benediktibk/battery-system/hardware/battery-management-system/design_errors_r03.txt

open:
footprint for EEPROM wrong
use INAs for cell measurement for increased precision

done:
