benediktibk/battery-system/calculations/battery_system.ods

Sheet: specifications
maximum current [A] | 30
minimum cell voltage [V] | 2.5
maximum cell voltage [V] | 3.6
cell series count | 4
minimum battery voltage [V] | 10
maximum battery voltage [V] | 14.4
cell capacity [Ah] | 88
nominal cell voltage [V] | 3.2
nominal battery voltage [V] | 12.8
cell energy [Wh] | 1126.4
maximum input voltage [V] | 30
internal resistance [Ohm] | 0.2

Sheet: charge and discharge FETs
pull up [kOhm] | 220
pull up current [mA] | 0.0581818181818182
drain source resistance [mOhm] | 7
power loss per FET [mW] | 210
power loss per pull up [mW] | 0.745
complete discharge time per pull up [h] | 1512500
complete discharge time per pull up [a] | 173
input capacitance [pF] | 4140
input capacitance tau [s] | 0.0009108
loading time input capacitance [us] | 2094.84

Sheet: balancing
cell voltage difference [V] | 0.1
cell capacitance [F] | 99000
energy difference [Ws] | 15840
balance time [s] | 3600
average balance power [W] | 4.4
charging factor | 1.59
peak power [W] | 13.97
peak current necessary [A] | 4.37
RDS on [Ohm] | 0.05
damping resistor [Ohm] | 0.002
total charge resistance [Ohm] | 0.302
Initial peak current [A] | 10.596
continuous peak current [A] | 0.331
initial power loss damping resistor [W] | 0.225
continuous power loss damping resistor [W] | 0.000
continuous power loss charge [W] | 0.0331125827814571
capacity [F] | 0.01
charging tau [s] | 0.00302
time till 90% full [s] | 0.006954
time till 90% full [us] | 6954
MOSFET turn on and turn of time [ns] | 61
MOSFET turn on and turn of time [s] | 0.000000061
charge and balance time [s] | 0.013907735961684
charge and balance time [ms] | 13.908
energy transferred per charge [Ws] | 0.0000404
energy transferred per cycle [Ws] | 0.0000202
time till balanced [s] | 784158415.841584
time till balanced [h] | 217821.782178218
time till balanced [a] | 24.8484807412979

Sheet: balancing_relais
cell voltage difference [V] | 0.1
cell capacitance [F] | 99000
energy difference [Ws] | 15840
reed resistance [Ohm] | 0.15
reed maximum current [A] | 1
initial current [A] | 0.35
charging capacitor [F] | 360.00
series resistance capacitor [Ohm] | 0.135
charging tau [s] | 102.60
time till 90% full [s] | 236.25
energy transfer per cycle [Ws] | 1.46
time till balanced [s] | 10864.1975308642
time till balanced [h] | 3.01783264746228
cycles till balanced | 45.987
energy stored in balancing capacitor [Ws] | 2332.800
energy stored in battery pack [Ws] | 4055040.000
energy stored in balancing capacitor [%] | 0.058

Sheet: supercap_selection
RS order number | capacitance [F] | Price [€] | price per capacitance [€/F]
875-6723 | 15 | 3.709 | 0.247
875-6720 | 90 | 8.755 | 0.097

Sheet: balancing_inductor
cell voltage difference [V] | 0.1
cell capacitance [F] | 99000
energy difference [Ws] | 15840
inductance [H] | 0.0022 | Würth 7447709222
parasitic resistance [Ohm] | 3.25
maximum DC current [A] | 0.53
saturation current [A] | 0.75
resistance nmos [Ohm] | 0.2
number of inductors | 1
total resistance [Ohm] | 3.45
total inductance [H] | 0.0022
initial current [A] | 1.04347826086957
time constant [s] | 0.00063768115942029
cycle time on [s] | 0.00063768115942029
cycle time off [s] | 0.00127536231884058
total cycle time [s] | 0.00191304347826087
energy loss per cycle, approx [Ws] | 0.00718638941398866
energy transfer per cycle, approx [Ws] | 0.0269958280595052
power transfer, approx [W] | 3.75652173913044
time till balanced [s] | 4216.66666666667
time till balanced [h] | 1.1712962962963

Sheet: balancing_inductor_v2
cell voltage difference [V] | 0.1
cell capacitance [F] | 99000
energy difference [Ws] | 15840
inductance [µH] | 6.2 | Würth 7447706062
inductance [H] | 0.0000062
parasitic resistance [Ohm] | 0.015
maximum DC current [A] | 7
saturation current [A] | 10
resistance nmos [Ohm] | 0.028 | DMN3404L
additional resistance [Ohm] | 0.5
power loss on resistance, peak [W] | 21.9773511187082 | RS online 820-0069
total resistance [Ohm] | 0.543
total inductance [H] | 0.0000062
initial current [A] | 6.62983425414365
time constant [s] | 1.14180478821363E-05
cycle time on [s] | 1.14180478821363E-05
cycle time off [s] | 2.28360957642726E-05
total cycle time [s] | 3.42541436464088E-05
energy loss per cycle, approx [Ws] | 0.000817557461615946
energy transfer per cycle, approx [Ws] | 0.0195129736695077
power transfer, approx [W] | 23.8674033149171
time till balanced [s] | 663.666666666667
time till balanced [h] | 0.184351851851852
maximum PWM count frequency [MHz] | 32
minimum PWM count period [s] | 0.00000003125
turn on delay time [ns] | 3.41
turn on rise time [ns] | 6.18
turn off delay time [ns] | 13.92
turn off fall time [ns] | 2.84
switching time [s] | 0.00000002635
power loss nmos [W] | 1.23073166264766

Sheet: balancing_inductor_v3
cell voltage difference [V] | 0.1
cell capacitance [F] | 99000
energy difference [Ws] | 15840
inductance [µH] | 220 | 789-6971
inductance [H] | 0.00022
parasitic resistance [Ohm] | 0.439
maximum DC current [A] | 1
saturation current [A] | 1
resistance nmos [Ohm] | 0.028 | DMN3404L
additional resistance [Ohm] | 3.544
power loss on resistance, peak [W] | 2.85491636966181 | RS online 820-0069
total resistance [Ohm] | 4.011
total inductance [H] | 0.00022
initial current [A] | 0.897531787584144
time constant [s] | 5.48491647968088E-05
cycle time on [s] | 0.000054849
cycle time off [s] | 0.000109698329593618
total cycle time [s] | 0.000164547494390426
energy loss per cycle, approx [Ws] | 0.000531671784417832
energy transfer per cycle, approx [Ws] | 0.00171789237747572
power transfer, approx [W] | 3.23111443530292
time till balanced [s] | 4902.33333333333
time till balanced [h] | 1.36175925925926
maximum PWM count frequency [MHz] | 32
minimum PWM count period [s] | 0.00000003125
turn on delay time [ns] | 3.41
turn on rise time [ns] | 6.18
turn off delay time [ns] | 13.92
turn off fall time [ns] | 2.84
switching time [s] | 0.00000002635
power loss nmos [W] | 0.0225557726722717
