benediktibk/battery-system/casing/casing-complete_lid.stl

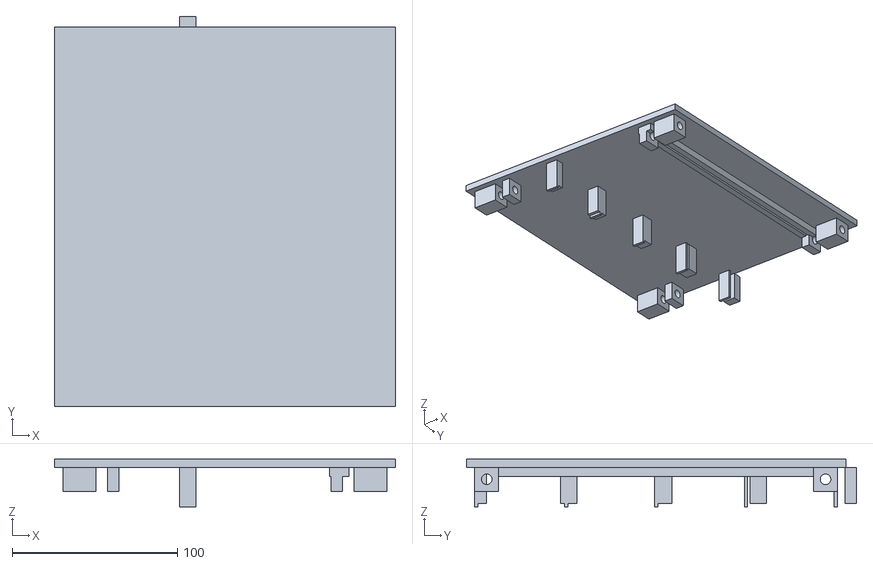
[picture p1: CAD file, 2024-04-21]
casing/casing-complete_lid.stl
206.4 x 236.1 x 29.0
