benediktibk/battery-system/casing/casing-complete_base.stl

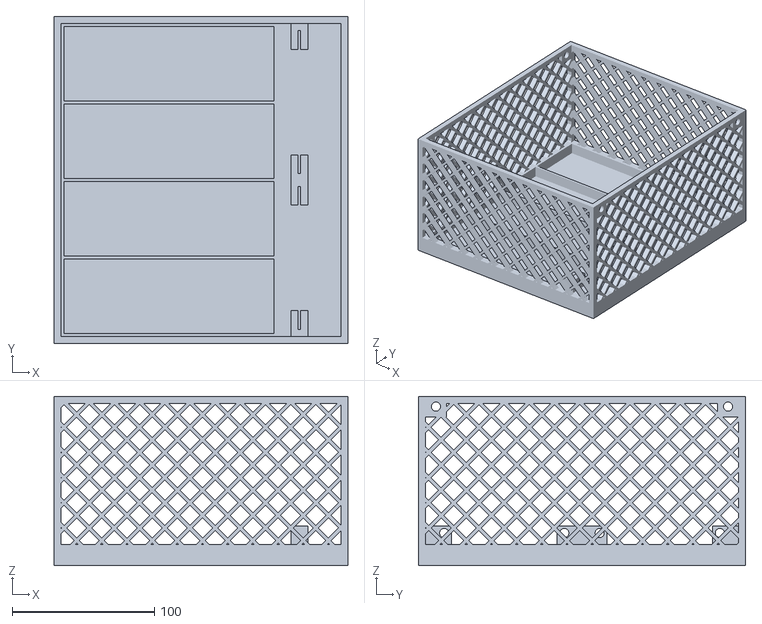
[picture p2: CAD file, 2024-04-21]
casing/casing-complete_base.stl
206.4 x 229.6 x 119.0
