benediktibk/battery-system/casing/casing-cells.stl

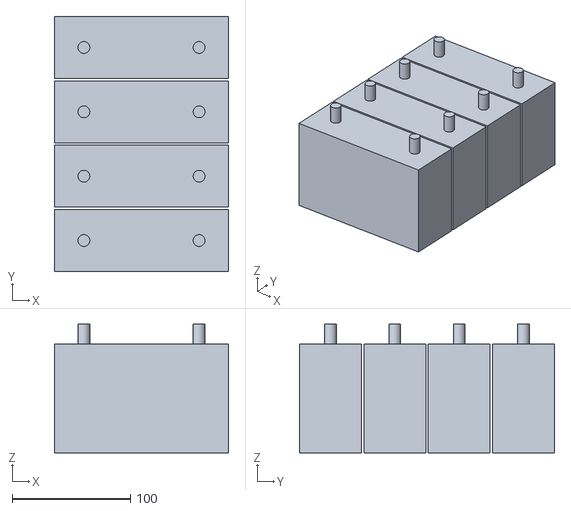
[picture p3: CAD file, 2024-04-21]
casing/casing-cells.stl
147.4 x 215.6 x 109.0
