benediktibk/battery-system/casing/casing.FCStd

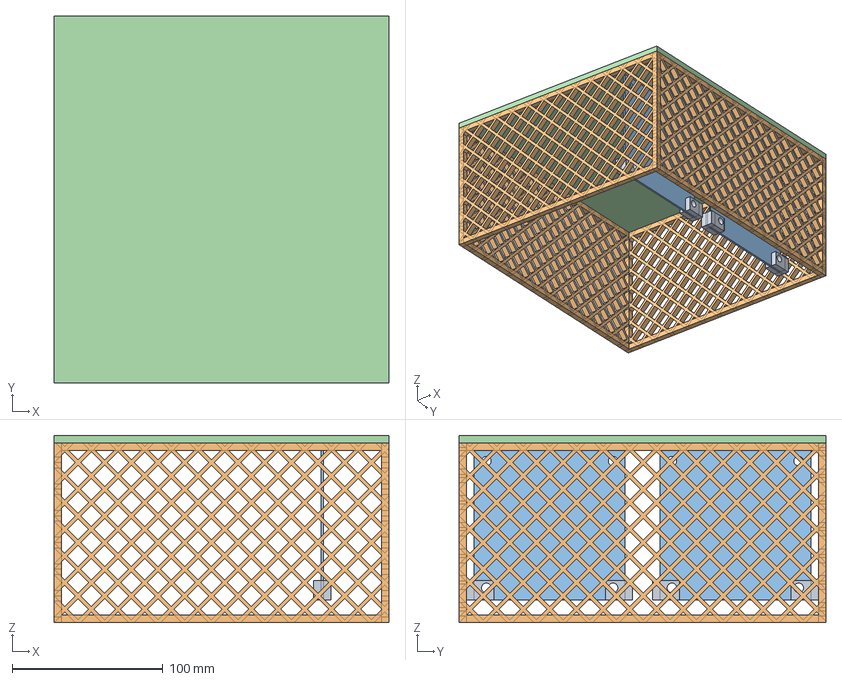
[picture p4: CAD file, 2024-04-16]
casing/casing.FCStd
222.0 x 243.0 x 124.0 mm
pcb_mounts
walls
pcbs
lid_plate
