benediktibk/battery-system/simulations/cell_measurement.asc

M1: pmos
M2: pmos
M3: pmos
M4: pmos
M5: nmos
R1: res; 1000000
R2: res; 100000
R3: res; 24000
R4: res; 100000
R5: res; 100000
R6: res; 24000
R7: res; 36000
R8: res; 68000
R9: res; 100000
R10: res; 1000
R11: res; 1000
R12: res; 1000
R13: res; 1000
U1: AD711
U2: AD711
U3: AD711
U4: AD711
V1: voltage; 20
V2: voltage; 3
V3: voltage; 3
V4: voltage; 3
V5: voltage; 3
V6: voltage; PULSE(0 3.3 0.1 0.001 0.001 1)
Named nets: 0
.tran 1
