benediktibk/battery-system/simulations/battery_cell_configuration_change.asc

C1: cap; 99000; Rser=100m,IC=2
C2: cap; 99000; Rser=100m,IC=2
M1: nmos; Si7336ADP
M2: nmos; Si7336ADP
M3: nmos; Si7336ADP
M4: nmos; Si7336ADP
M5: nmos; Si7336ADP
M6: nmos; Si7336ADP
R1: res; 2000
R2: res; 1000
R3: res; 2000
V1: voltage; PULSE(10 0 0.5 0 0 0.5 1)
V2: voltage; PULSE(0 10 0.1 0 0 0.1 0.2)
Named nets: 0
.tran 1
