benediktibk/battery-system/simulations/Draft3.asc

C1: cap; 0.000056; Rser=0.002
C2: cap; 0.000056; Rser=0.002
L1: ind; 0.0000025; Ipk=100 Rser=2.6m
M1: nmos; Si7336ADP
M2: nmos; Si7336ADP
M3: nmos
R2: res; 0.004
R3: res; 240
R4: res; 100000
V1: voltage; 12
V2: voltage; PULSE(0 30 0.1 0 0 0.855u 10u)
V3: voltage; 30
Named nets: 0
.tran 1
