benediktibk/battery-system/simulations/dc_dc_converter_filter.asc

C1: cap; 0.0000470
L1: ind; 0.0000025
R: res; 2.4
V1: voltage; PULSE(24 24.037 0 0.000001 0.000001 0.000001 0.000004)
Named nets: 0
.tran 0.1
