benediktibk/battery-system/simulations/Draft2.asc

M1: pmos
M2: nmos
R1: res; 220000
R2: res; 1000
V1: voltage; 18
V2: voltage; PULSE(0 3 1 0 0 1 1)
Named nets: 0
