benediktibk/battery-system/simulations/high_side_switch.asc

M1: pmos; AO6407
M2: nmos; BSB012N03LX3
R1: res; 220000
R2: res; 1000
V1: voltage; 18
V2: voltage; PULSE(0 3 1 0 0 1 2)
Named nets: 0
.tran 10
