benediktibk/battery-system/simulations/balance_inductance_v3.asc

C1: cap; 99000; Rser=0.2,IC=3.2
C2: cap; 99000; Rser=0.2,IC=3.2
C3: cap; 99000; Rser=0.2,IC=3.2
C5: cap; 99000; Rser=0.2,IC=3.3
L1: ind; 0.00022; Rser=0.439
L2: ind; 0.00022; Rser=0.439
L3: ind; 0.00022; Rser=0.439
L4: ind; 0.00022; Rser=0.439
M1: nmos; BSB012N03LX3
M2: nmos; BSB012N03LX3
M3: nmos; BSB012N03LX3
M4: nmos; BSB012N03LX3
M5: nmos; BSB012N03LX3
M6: nmos; BSB012N03LX3
M7: nmos; BSB012N03LX3
M8: nmos; BSB012N03LX3
M9: nmos; BSB012N03LX3
M10: nmos; BSB012N03LX3
M11: nmos; BSB012N03LX3
M12: nmos; BSB012N03LX3
R1: res; 100
R2: res; 100
R3: res; 100
R4: res; 100
V1: voltage; PULSE(0 18 0 0 0 0.0005 0.00055)
V2: voltage; 18
V3: voltage; PULSE(0 18 0.01 0 0 1 1.01)
Named nets: 0
.tran 100
