benediktibk/battery-system/simulations/Draft1.asc

C1: cap; 99000; Rser=0.2,IC=3.2
C2: cap; 99000; Rser=0.2,IC=3.3
C3: cap; 99000; Rser=0.2,IC=3.2
C4: cap; 99000; Rser=0.2,IC=3.2
D1: schottky; 1N5817
D2: schottky; 1N5817
L1: ind; 0.01; Ipk=0.11 Rser=39
M1: nmos; BSB012N03LX3
M2: nmos; BSB012N03LX3
M3: nmos; BSB012N03LX3
M4: nmos; BSB012N03LX3
M5: nmos; BSB012N03LX3
R1: res; 100000
V1: voltage; PULSE(0 18 0.1 0 0 0.0005 0.001)
V2: voltage; 18
Named nets: 0
.tran 100
