benediktibk/battery-system/simulations/balance_fets.asc

C1: cap; 99000; IC=3.2
C2: cap; 99000; IC=3.3
C3: cap; 0.010
C4: cap; 0.010
C5: cap; 0.001
C6: cap; 0.001
M1: nmos; PSMN0R925YLC
M2: nmos; PSMN0R925YLC
M3: nmos; PSMN0R925YLC
M4: nmos; PSMN0R925YLC
M5: nmos; PSMN0R925YLC
M6: nmos; PSMN0R925YLC
M7: nmos; PSMN0R925YLC
M8: nmos; PSMN0R925YLC
M9: nmos; PSMN0R925YLC
M10: nmos; PSMN0R925YLC
M11: nmos; PSMN0R925YLC
M12: nmos; PSMN0R925YLC
R1: res; 0.5
R2: res; 0.5
R3: res; 1000
R4: res; 1000
R5: res; 1000
R6: res; 1000
R7: res; 0.2
R8: res; 0.2
V1: voltage; PULSE(0 3.3 0.1 0 0 0.001 0.0025)
V2: voltage; PULSE(0 3.3 0.1015 0 0 0.0005 0.0025)
V3: voltage; 20
Named nets: 0, charge_pmos, charge_nmos, balance_pmos, balance_nmos, charge, balance
.tran 100
