benediktibk/battery-system/simulations/charge_and_discharge_fets.asc

D1: diode; customDiode
D2: diode; customDiode
M1: nmos
M2: nmos
Qcharge: pmos; AO6407
Qdischarge: pmos; AO6407
R1: res; 0.1
R2: res; 10
R3: res; 100000
R4: res; 100000
V1: voltage; 12
V2: voltage; 0
V3: voltage; 14
V4: voltage; 0
Named nets: 0
.op
.model customDiode D(Ron=1 Roff=1Meg Vfwd=0.5 Vrev=2)
