benediktibk/battery-system/hardware/battery-management-system/battery-management-system.kicad_pcb

## KiCad design hardware/battery-management-system/battery-management-system.kicad_pcb (2025-03-11)

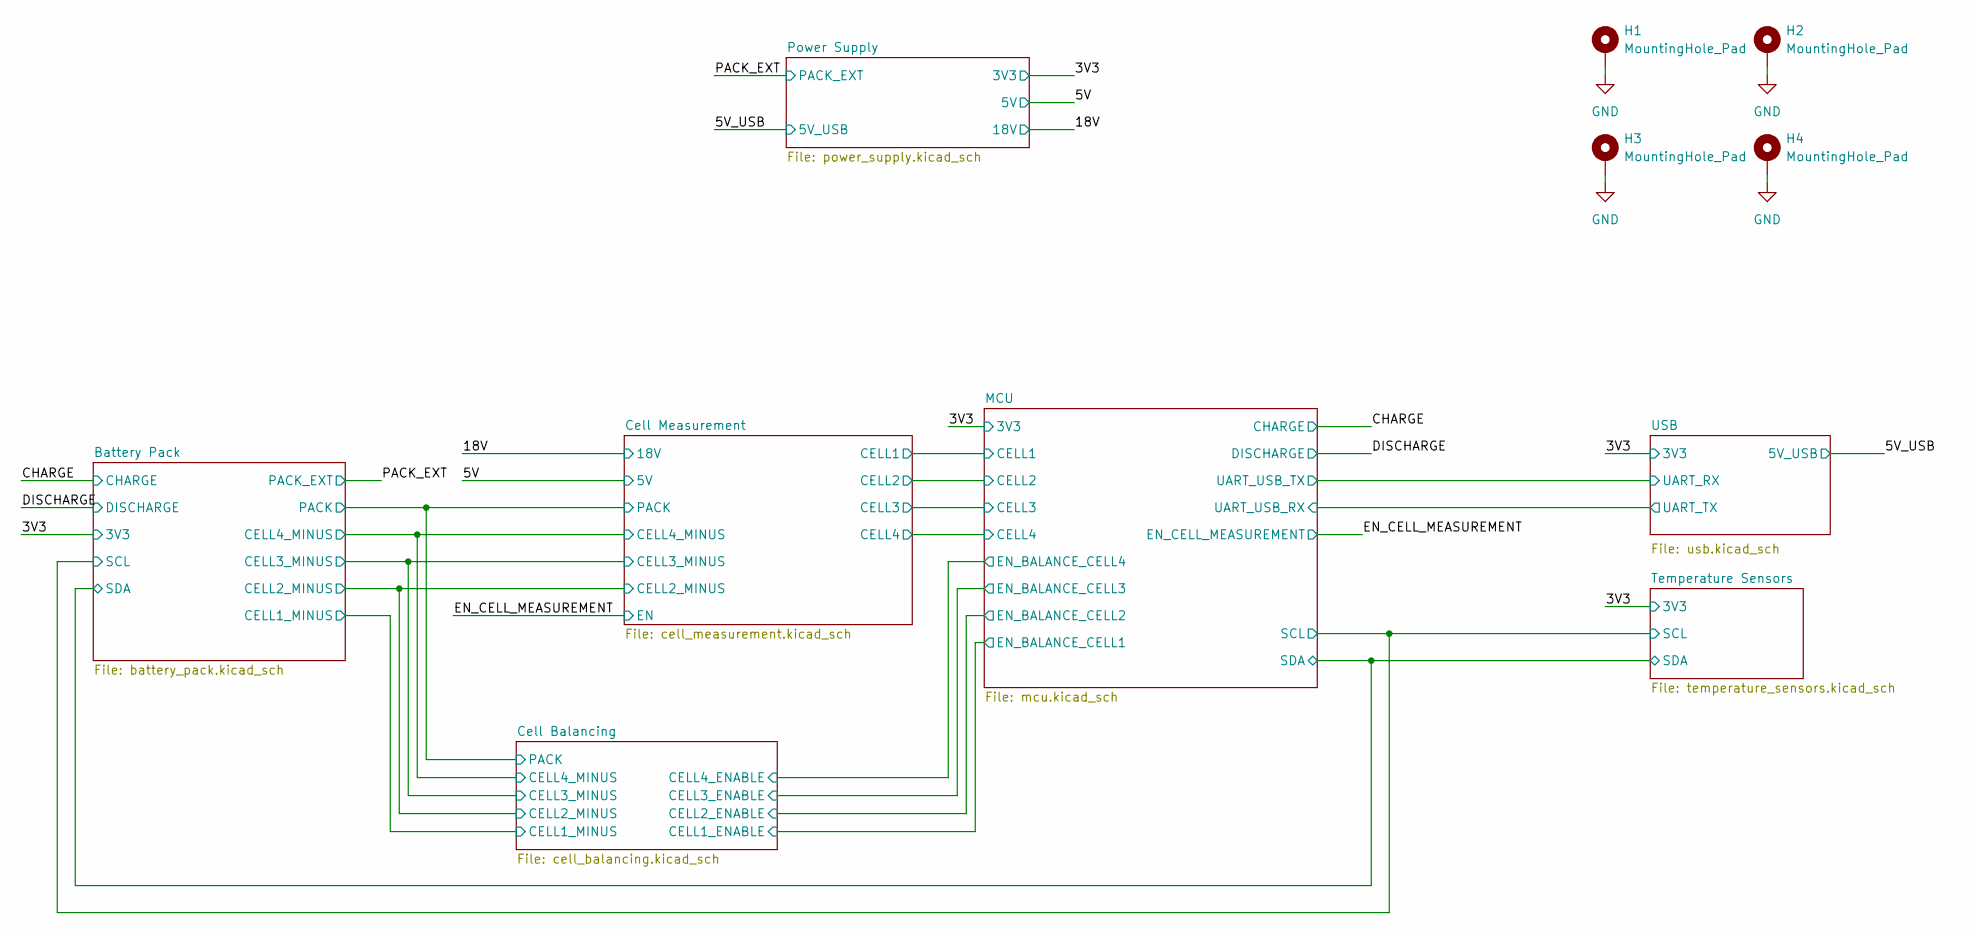
[picture p5: schematic battery-management-system.kicad_sch]

Parts:
H1, H2, H3, H4: MountingHole_Pad; MountingHole_6.4mm_M6_Pad_TopBottom

Connections:
GND: H1.1, H2.1, H3.1, H4.1; also elsewhere on the board

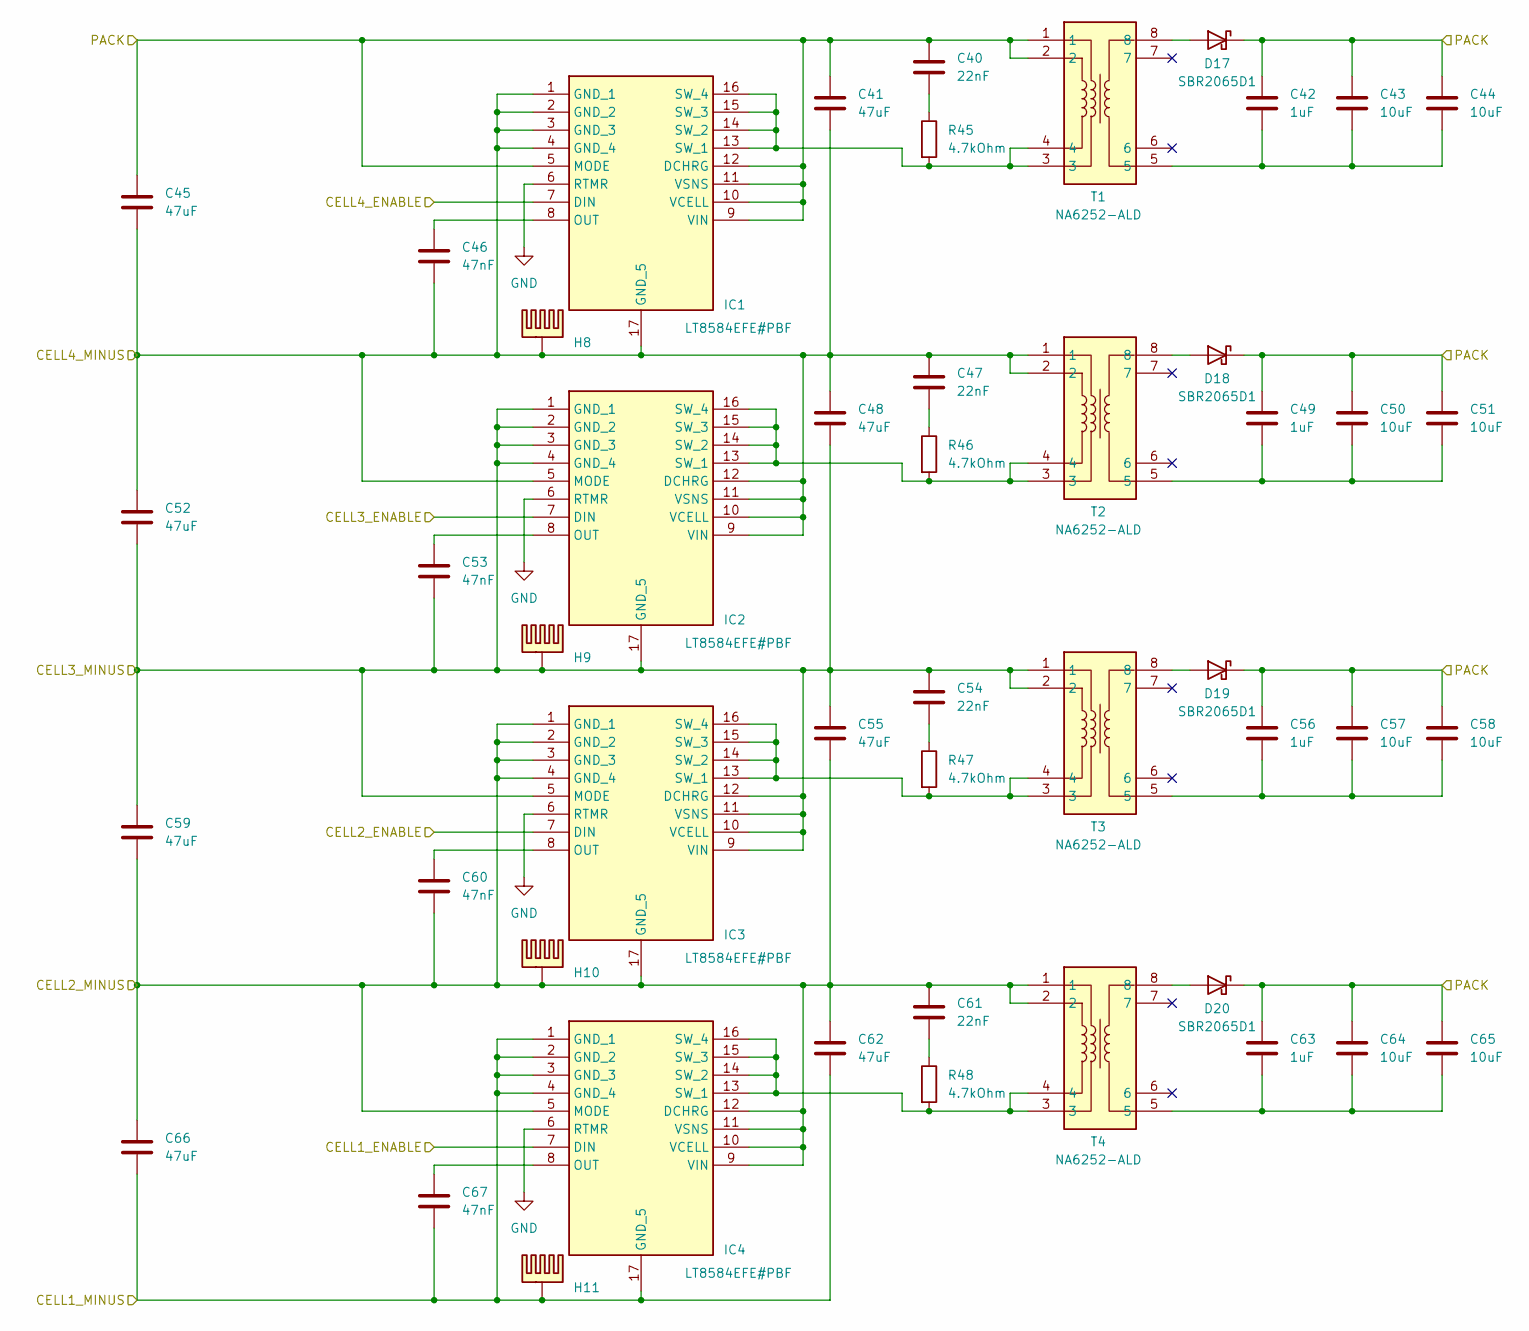
[picture p6: schematic cell_balancing.kicad_sch]

Parts:
C40, C47, C54, C61: 22nF; C_0603_1608Metric_Pad1.08x0.95mm_HandSolder; Mouser Part Number 80-C0603C223K4R
C41, C45, C48, C52, C55, C59, C62, C66: 47uF; C_1206_3216Metric_Pad1.33x1.80mm_HandSolder; Mouser Part Number 810-C3216X5R1E476M
C42, C49, C56, C63: 1uF; C_0603_1608Metric_Pad1.08x0.95mm_HandSolder; Mouser Part Number 963-UMK107BJ105KA-T
C43, C44, C50, C51, C57, C58, C64, C65: 10uF; C_1210_3225Metric_Pad1.33x2.70mm_HandSolder; Mouser Part Number 187-CL31A106MBHNNNE
C46, C53, C60, C67: 47nF; C_0603_1608Metric_Pad1.08x0.95mm_HandSolder; Mouser Part Number 80-C0603C473K4RACLR
D17, D18, D19, D20: SBR2065D1; Mouser Part Number 621-SBR2065D1-13
H8, H9, H10, H11: heatsink_18x18; Mouser Part Number 490-HSB06-181810; Mouser order number 490-HSB06-181810
IC1, IC2, IC3, IC4: LT8584EFE#PBF; SOP65P640X110-17N; Mouser Part Number 584-LT8584EFE#PBF; Mouser order number 584-LT8584EFE#PBF
R45, R46, R47, R48: 4.7kOhm; R_0603_1608Metric_Pad0.98x0.95mm_HandSolder; Mouser Part Number 652-CR0603FX-4701ELF
T1, T2, T3, T4: NA6252-ALD; SOP250P1524X1143-8N; Mouser Part Number 994-NA6252-ALD; Mouser order number 994-NA6252-ALD

Connections:
/Battery Pack/CELL1_MINUS: C62.2, C66.2, C67.2, H11.PAD, IC4.1 (GND_1), IC4.2 (GND_2), IC4.3 (GND_3), IC4.4 (GND_4), IC4.17 (GND_5); also elsewhere on the board
/Battery Pack/CELL2_MINUS: C55.2, C59.2, C60.2, C61.1, C62.1, C66.1, H10.PAD, IC3.1 (GND_1), IC3.2 (GND_2), IC3.3 (GND_3), IC3.4 (GND_4), IC3.17 (GND_5), IC4.5 (MODE), IC4.9 (VIN), IC4.10 (VCELL), IC4.11 (VSNS), IC4.12 (DCHRG), T4.1, T4.2; also elsewhere on the board
/Battery Pack/CELL3_MINUS: C48.2, C52.2, C53.2, C54.1, C55.1, C59.1, H9.PAD, IC2.1 (GND_1), IC2.2 (GND_2), IC2.3 (GND_3), IC2.4 (GND_4), IC2.17 (GND_5), IC3.5 (MODE), IC3.9 (VIN), IC3.10 (VCELL), IC3.11 (VSNS), IC3.12 (DCHRG), T3.1, T3.2; also elsewhere on the board
/Battery Pack/CELL4_MINUS: C41.2, C45.2, C46.2, C47.1, C48.1, C52.1, H8.PAD, IC1.1 (GND_1), IC1.2 (GND_2), IC1.3 (GND_3), IC1.4 (GND_4), IC1.17 (GND_5), IC2.5 (MODE), IC2.9 (VIN), IC2.10 (VCELL), IC2.11 (VSNS), IC2.12 (DCHRG), T2.1, T2.2; also elsewhere on the board
/Battery Pack/PACK: C40.1, C41.1, C42.1, C43.1, C44.1, C45.1, C49.1, C50.1, C51.1, C56.1, C57.1, C58.1, C63.1, C64.1, C65.1, D17.2 (K), D18.2 (K), D19.2 (K), D20.2 (K), IC1.5 (MODE), IC1.9 (VIN), IC1.10 (VCELL), IC1.11 (VSNS), IC1.12 (DCHRG), T1.1, T1.2; also elsewhere on the board
/Cell Balancing/CELL1_ENABLE: IC4.7 (DIN); also elsewhere on the board
/Cell Balancing/CELL2_ENABLE: IC3.7 (DIN); also elsewhere on the board
/Cell Balancing/CELL3_ENABLE: IC2.7 (DIN); also elsewhere on the board
/Cell Balancing/CELL4_ENABLE: IC1.7 (DIN); also elsewhere on the board
GND: IC1.6 (RTMR), IC2.6 (RTMR), IC3.6 (RTMR), IC4.6 (RTMR); also elsewhere on the board
unnamed: C40.2, R45.1
unnamed: C42.2, C43.2, C44.2, T1.5
unnamed: C47.2, R46.1
unnamed: C49.2, C50.2, C51.2, T2.5
unnamed: C54.2, R47.1
unnamed: C56.2, C57.2, C58.2, T3.5
unnamed: C61.2, R48.1
unnamed: C63.2, C64.2, C65.2, T4.5
unnamed: D17.1 (A), T1.8
unnamed: D18.1 (A), T2.8
unnamed: D19.1 (A), T3.8
unnamed: D20.1 (A), T4.8
unnamed: C46.1, IC1.8 (OUT)
unnamed: IC1.13 (SW_1), IC1.14 (SW_2), IC1.15 (SW_3), IC1.16 (SW_4), R45.2, T1.3, T1.4
unnamed: C53.1, IC2.8 (OUT)
unnamed: IC2.13 (SW_1), IC2.14 (SW_2), IC2.15 (SW_3), IC2.16 (SW_4), R46.2, T2.3, T2.4
unnamed: C60.1, IC3.8 (OUT)
unnamed: IC3.13 (SW_1), IC3.14 (SW_2), IC3.15 (SW_3), IC3.16 (SW_4), R47.2, T3.3, T3.4
unnamed: C67.1, IC4.8 (OUT)
unnamed: IC4.13 (SW_1), IC4.14 (SW_2), IC4.15 (SW_3), IC4.16 (SW_4), R48.2, T4.3, T4.4

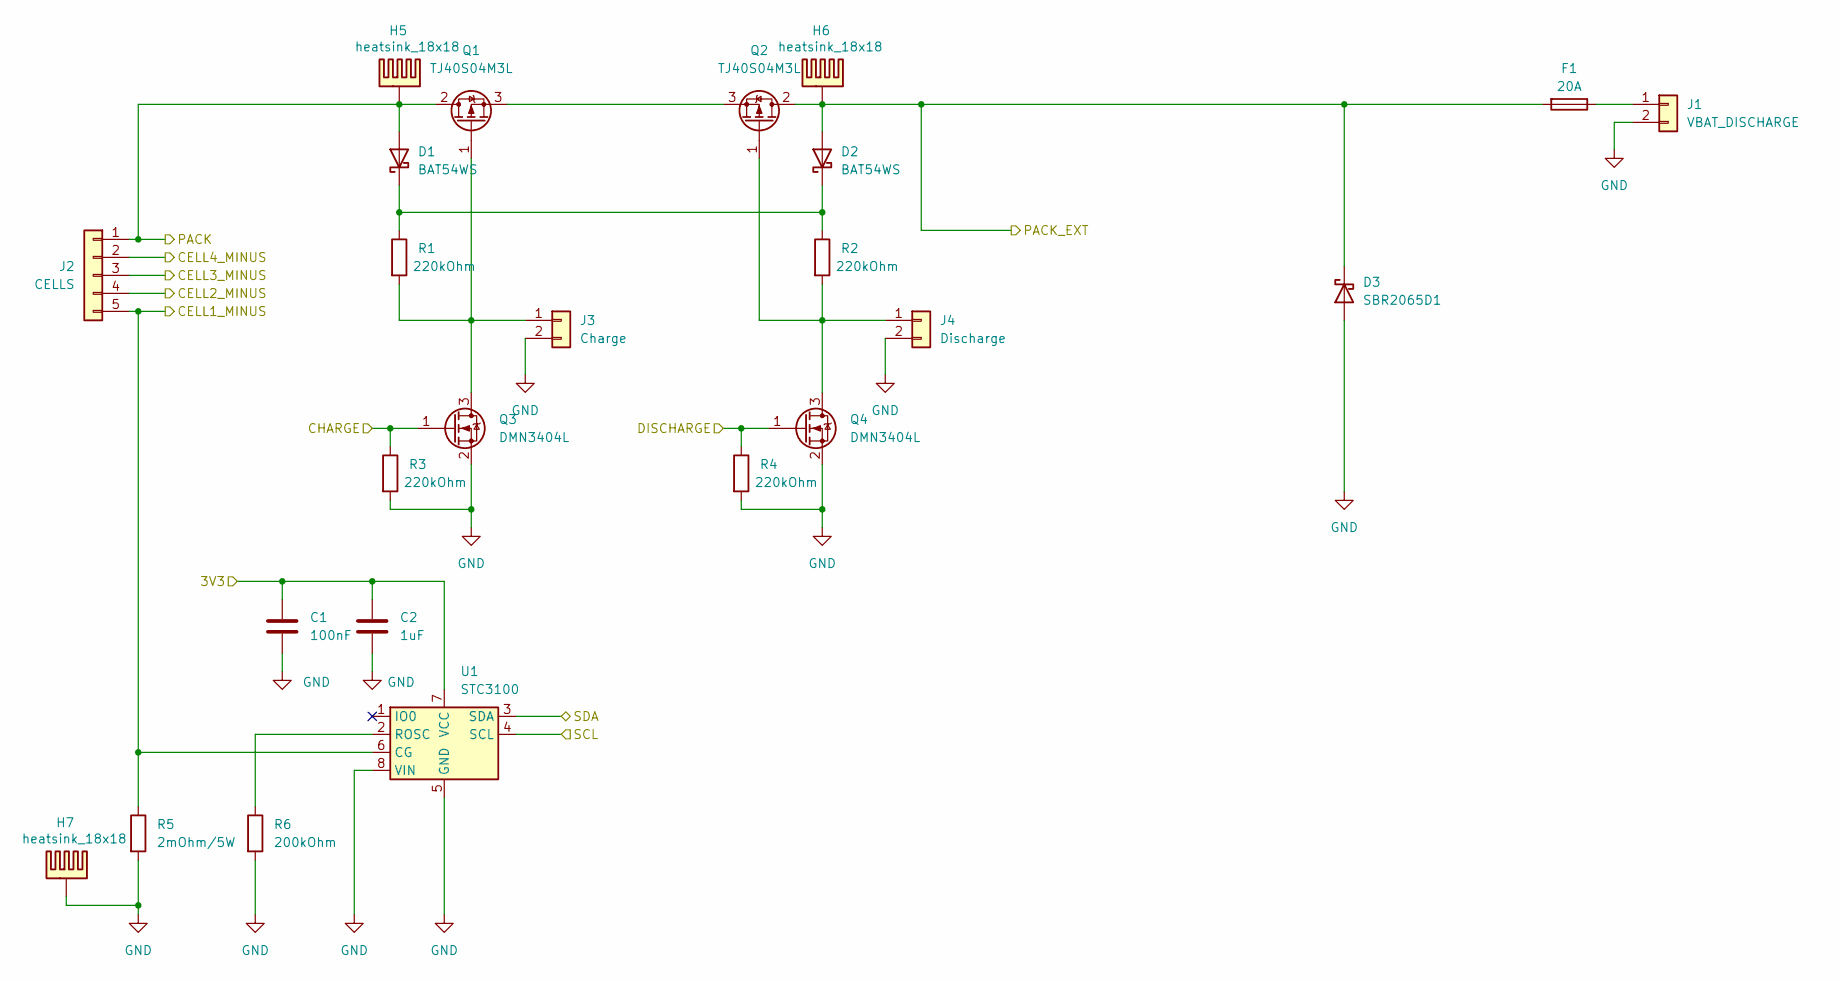
[picture p7: schematic battery_pack.kicad_sch]

Parts:
C1: 100nF; C_0603_1608Metric_Pad1.08x0.95mm_HandSolder; Mouser Part Number 581-KGM15BR71H104KM
C2: 1uF; C_0603_1608Metric_Pad1.08x0.95mm_HandSolder; Mouser Part Number 963-UMK107BJ105KA-T
D1, D2: BAT54WS; D_SOD-323; Mouser Part Number 637-BAT54WS
D3: SBR2065D1; Mouser Part Number 621-SBR2065D1-13
F1: 20A; KEYSTONE_blade_fus_holder
H5, H6, H7: heatsink_18x18; Mouser Part Number 490-HSB06-181810; Mouser order number 490-HSB06-181810
J1: VBAT_DISCHARGE; rspro_header_2pin_5_08mm
J2: CELLS; rspro_header_5pin_5_08mm
J3: Charge; PinHeader_1x02_P2.54mm_Vertical
J4: Discharge; PinHeader_1x02_P2.54mm_Vertical
Q1, Q2: TJ40S04M3L; TO-252-2; Mouser Part Number 757-TJ40S04M3LT6L1NQ
Q3, Q4: DMN3404L; SOT-23; Mouser Part Number 621-DMN3404L-7
R1, R2, R3, R4: 220kOhm; R_0603_1608Metric_Pad0.98x0.95mm_HandSolder; Mouser Part Number 71-CRCW0603-220K-E3
R5: 2mOhm/5W; R_2512_6332Metric_Pad1.40x3.35mm_HandSolder; Mouser Part Number 660-TLR3APSDTE2L00F7
R6: 200kOhm; R_0603_1608Metric_Pad0.98x0.95mm_HandSolder; Mouser Part Number 667-ERA-3AEB204V
U1: STC3100; MSOP-8_3x3mm_P0.65mm; Mouser Part Number 511-STC3100IST

Connections:
/3V3: C1.1, C2.1, U1.7 (VCC); also elsewhere on the board
/Battery Pack/CELL1_MINUS: J2.5, R5.1, U1.6 (CG); also elsewhere on the board
/Battery Pack/CELL2_MINUS: J2.4; also elsewhere on the board
/Battery Pack/CELL3_MINUS: J2.3; also elsewhere on the board
/Battery Pack/CELL4_MINUS: J2.2; also elsewhere on the board
/Battery Pack/PACK: D1.2 (A), H5.PAD, J2.1, Q1.2 (D); also elsewhere on the board
/CHARGE: Q3.1 (G), R3.1; also elsewhere on the board
/DISCHARGE: Q4.1 (G), R4.1; also elsewhere on the board
/MCU/SCL: U1.4 (SCL); also elsewhere on the board
/MCU/SDA: U1.3 (SDA); also elsewhere on the board
/PACK_EXT: D2.2 (A), D3.2 (K), F1.2, H6.PAD, Q2.2 (D); also elsewhere on the board
GND: C1.2, C2.2, D3.1 (A), H7.PAD, J1.2, J3.2, J4.2, Q3.2 (S), Q4.2 (S), R3.2, R4.2, R5.2, R6.2, U1.5 (GND), U1.8 (VIN); also elsewhere on the board
unnamed: D1.1 (K), D2.1 (K), R1.1, R2.1
unnamed: F1.1, J1.1
unnamed: J3.1, Q1.1 (G), Q3.3 (D), R1.2
unnamed: J4.1, Q2.1 (G), Q4.3 (D), R2.2
unnamed: Q1.3 (S), Q2.3 (S)
unnamed: R6.1, U1.2 (ROSC)

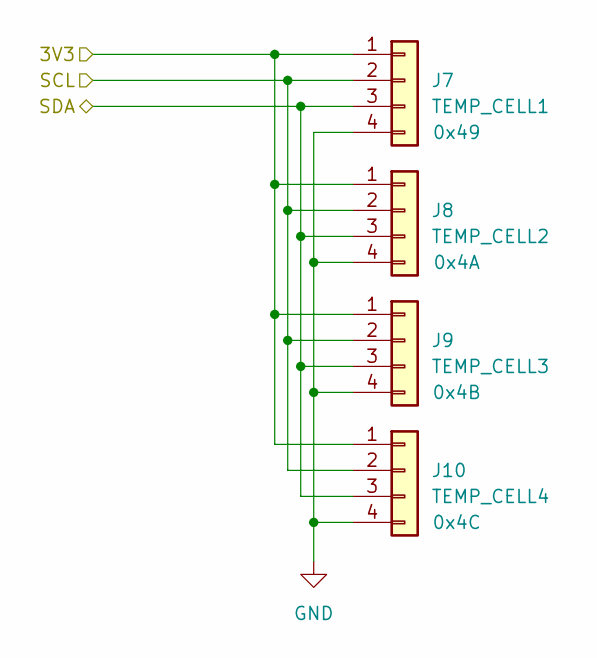
[picture p8: schematic temperature_sensors.kicad_sch]

Parts:
J7: TEMP_CELL1; rspro_header_4pin_3_5mm
J8: TEMP_CELL2; rspro_header_4pin_3_5mm
J9: TEMP_CELL3; rspro_header_4pin_3_5mm
J10: TEMP_CELL4; rspro_header_4pin_3_5mm

Connections:
/3V3: J7.1, J8.1, J9.1, J10.1; also elsewhere on the board
/MCU/SCL: J7.2, J8.2, J9.2, J10.2; also elsewhere on the board
/MCU/SDA: J7.3, J8.3, J9.3, J10.3; also elsewhere on the board
GND: J7.4, J8.4, J9.4, J10.4; also elsewhere on the board

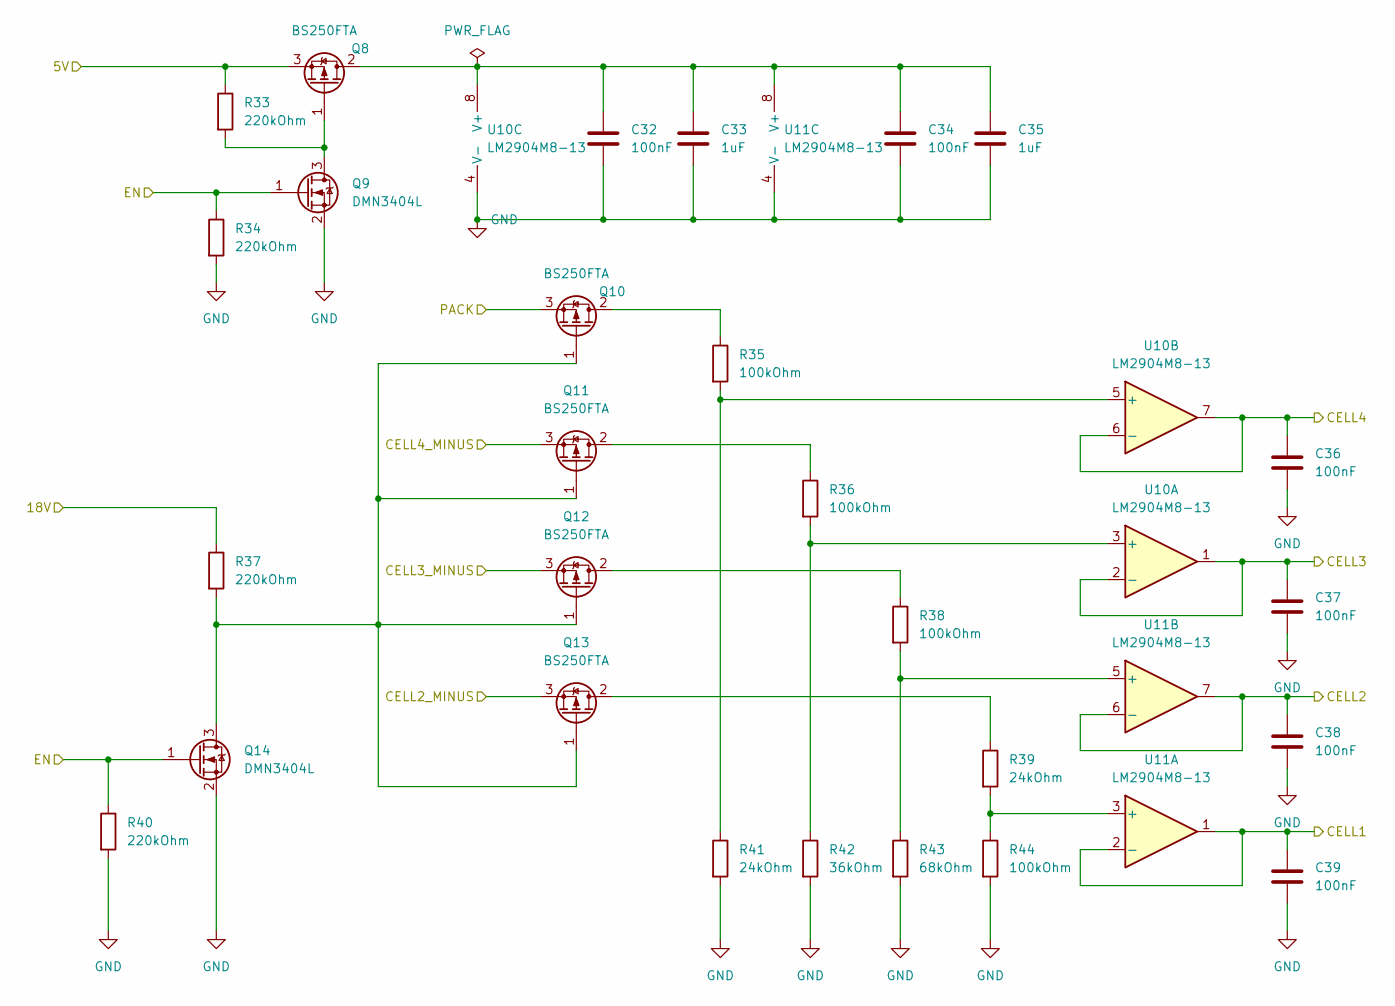
[picture p9: schematic cell_measurement.kicad_sch]

Parts:
C32, C34, C36, C37, C38, C39: 100nF; C_0603_1608Metric_Pad1.08x0.95mm_HandSolder; Mouser Part Number 581-KGM15BR71H104KM
C33, C35: 1uF; C_0603_1608Metric_Pad1.08x0.95mm_HandSolder; Mouser Part Number 963-UMK107BJ105KA-T
Q8, Q10, Q11, Q12, Q13: BS250FTA; SOT-23; Mouser Part Number 522-BS250FTA
Q9, Q14: DMN3404L; SOT-23; Mouser Part Number 621-DMN3404L-7
R33, R34, R37, R40: 220kOhm; R_0603_1608Metric_Pad0.98x0.95mm_HandSolder; Mouser Part Number 71-CRCW0603-220K-E3
R35, R36, R38, R44: 100kOhm; R_0603_1608Metric_Pad0.98x0.95mm_HandSolder; Mouser Part Number 603-RT0603FRE13100KL
R39, R41: 24kOhm; R_0603_1608Metric_Pad0.98x0.95mm_HandSolder; Mouser Part Number 71-CRCW060324K0FKEAC
R42: 36kOhm; R_0603_1608Metric_Pad0.98x0.95mm_HandSolder; Mouser Part Number 652-CR0603FX-3602ELF
R43: 68kOhm; R_0603_1608Metric_Pad0.98x0.95mm_HandSolder; Mouser Part Number 603-RT0603FRE0768KL
U10, U11: LM2904M8-13; MSOP-8_3x3mm_P0.65mm; Mouser Part Number 621-LM2904M8-13

Connections:
/5V: Q8.3 (S), R33.1; also elsewhere on the board
/18V: R37.1; also elsewhere on the board
/Battery Pack/CELL2_MINUS: Q13.3 (S); also elsewhere on the board
/Battery Pack/CELL3_MINUS: Q12.3 (S); also elsewhere on the board
/Battery Pack/CELL4_MINUS: Q11.3 (S); also elsewhere on the board
/Battery Pack/PACK: Q10.3 (S); also elsewhere on the board
/Cell Measurement/CELL1: C39.1, U11.1, U11.2 (-); also elsewhere on the board
/Cell Measurement/CELL2: C38.1, U11.6 (-), U11.7; also elsewhere on the board
/Cell Measurement/CELL3: C37.1, U10.1, U10.2 (-); also elsewhere on the board
/Cell Measurement/CELL4: C36.1, U10.6 (-), U10.7; also elsewhere on the board
/EN_CELL_MEASUREMENT: Q9.1 (G), Q14.1 (G), R34.1, R40.1; also elsewhere on the board
GND: C32.2, C33.2, C34.2, C35.2, C36.2, C37.2, C38.2, C39.2, Q9.2 (S), Q14.2 (S), R34.2, R40.2, R41.2, R42.2, R43.2, R44.2, U10.4 (V-), U11.4 (V-); also elsewhere on the board
unnamed: C32.1, C33.1, C34.1, C35.1, Q8.2 (D), U10.8 (V+), U11.8 (V+)
unnamed: Q8.1 (G), Q9.3 (D), R33.2
unnamed: Q10.2 (D), R35.1
unnamed: Q10.1 (G), Q11.1 (G), Q12.1 (G), Q13.1 (G), Q14.3 (D), R37.2
unnamed: Q11.2 (D), R36.1
unnamed: Q12.2 (D), R38.1
unnamed: Q13.2 (D), R39.1
unnamed: R36.2, R42.1, U10.3 (+)
unnamed: R35.2, R41.1, U10.5 (+)
unnamed: R39.2, R44.1, U11.3 (+)
unnamed: R38.2, R43.1, U11.5 (+)

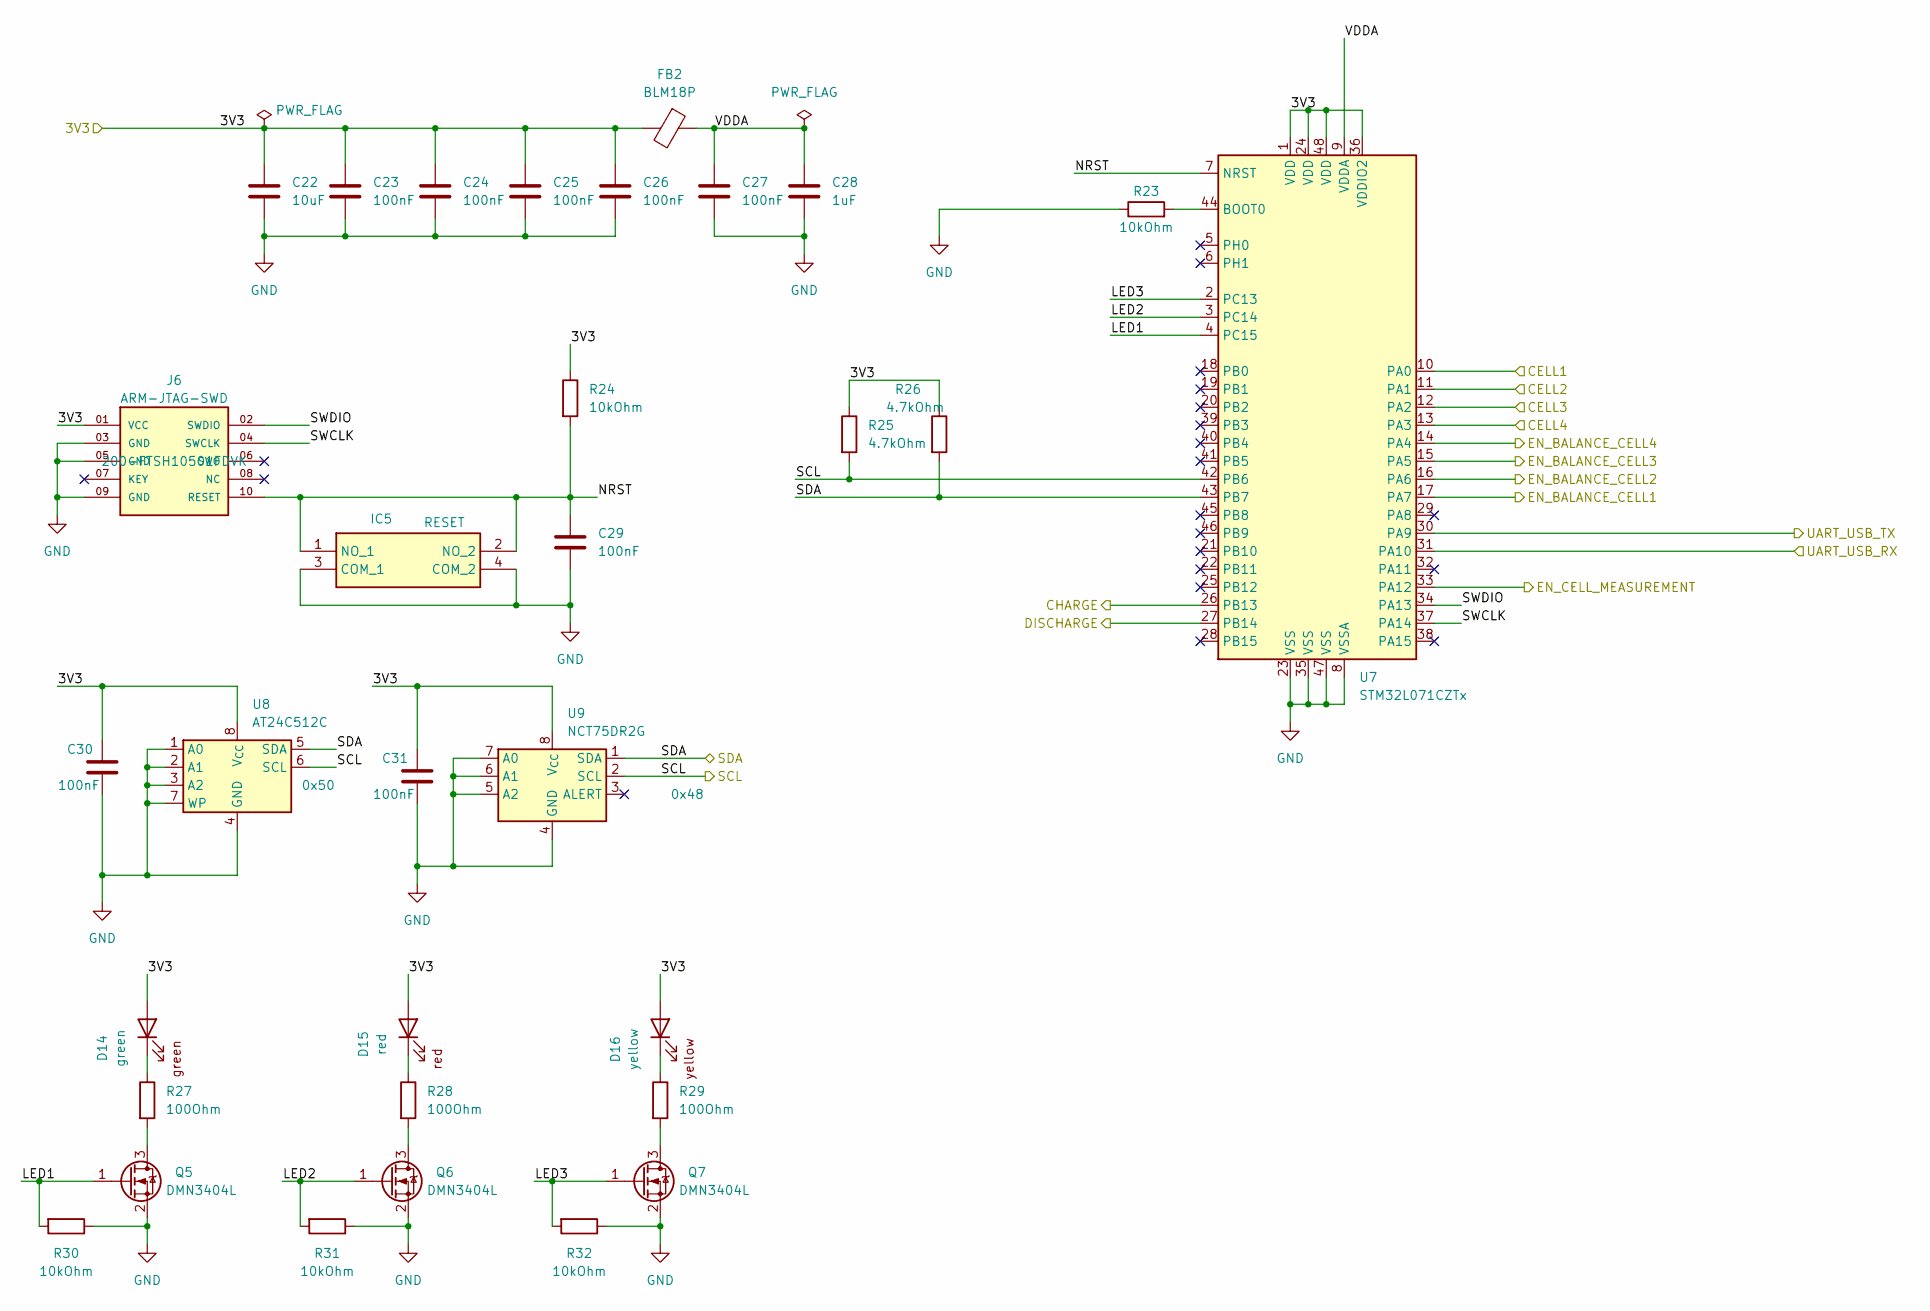
[picture p10: schematic mcu.kicad_sch]

Parts:
C22: 10uF; C_1210_3225Metric_Pad1.33x2.70mm_HandSolder; Mouser Part Number 187-CL31A106MBHNNNE
C23, C24, C25, C26, C27, C29, C30, C31: 100nF; C_0603_1608Metric_Pad1.08x0.95mm_HandSolder; Mouser Part Number 581-KGM15BR71H104KM
C28: 1uF; C_0603_1608Metric_Pad1.08x0.95mm_HandSolder; Mouser Part Number 963-UMK107BJ105KA-T
D14: green; D_0603_1608Metric_Pad1.05x0.95mm_HandSolder; Mouser Part Number 604-AP1608SGC
D15: red; D_0603_1608Metric_Pad1.05x0.95mm_HandSolder; Mouser Part Number 859-LTST-C190KDKT10A
D16: yellow; D_0603_1608Metric_Pad1.05x0.95mm_HandSolder; Mouser Part Number 604-APG1608SYKC/T
FB2: BLM18P; R_0603_1608Metric_Pad0.98x0.95mm_HandSolder; Mouser Part Number 81-BLM11P300S
IC5: RESET; TS026650BK100SCRD; Mouser Part Number 179-TS026650BK100SCR
J6: ARM-JTAG-SWD; SAMTEC_FTSH-105-01-F-DV-P-TR; Mouser Part Number 200-FTSH10501FDVK
Q5, Q6, Q7: DMN3404L; SOT-23; Mouser Part Number 621-DMN3404L-7
R23, R24, R30, R31, R32: 10kOhm; R_0603_1608Metric_Pad0.98x0.95mm_HandSolder; Mouser Part Number 652-CR0603FX-1002ELF
R25, R26: 4.7kOhm; R_0603_1608Metric_Pad0.98x0.95mm_HandSolder; Mouser Part Number 652-CR0603FX-4701ELF
R27, R28, R29: 100Ohm; R_0603_1608Metric_Pad0.98x0.95mm_HandSolder; Mouser Part Number 279-CRGH0603F100R
U7: STM32L071CZTx; LQFP-48_7x7mm_P0.5mm; Mouser Part Number 511-STM32L071CZT6
U8: AT24C512C; SOIC-8_3.9x4.9mm_P1.27mm; Mouser Part Number 556-AT24C512C-SSHM-T
U9: NCT75DR2G; SOIC-8_3.9x4.9mm_P1.27mm; Mouser Part Number 863-NCT75DR2G

Connections:
/3V3: C22.1, C23.1, C24.1, C25.1, C26.1, C30.1, C31.1, D14.2 (A), D15.2 (A), D16.2 (A), FB2.2, J6.01 (VCC), R24.1, R25.1, R26.1, U7.1 (VDD), U7.24 (VDD), U7.36 (VDDIO2), U7.48 (VDD), U8.8 (V_{CC}), U9.8 (V_{CC}); also elsewhere on the board
/CHARGE: U7.26 (PB13); also elsewhere on the board
/Cell Balancing/CELL1_ENABLE: U7.17 (PA7); also elsewhere on the board
/Cell Balancing/CELL2_ENABLE: U7.16 (PA6); also elsewhere on the board
/Cell Balancing/CELL3_ENABLE: U7.15 (PA5); also elsewhere on the board
/Cell Balancing/CELL4_ENABLE: U7.14 (PA4); also elsewhere on the board
/Cell Measurement/CELL1: U7.10 (PA0); also elsewhere on the board
/Cell Measurement/CELL2: U7.11 (PA1); also elsewhere on the board
/Cell Measurement/CELL3: U7.12 (PA2); also elsewhere on the board
/Cell Measurement/CELL4: U7.13 (PA3); also elsewhere on the board
/DISCHARGE: U7.27 (PB14); also elsewhere on the board
/EN_CELL_MEASUREMENT: U7.33 (PA12); also elsewhere on the board
/MCU/LED1: Q5.1 (G), R30.2, U7.4 (PC15)
/MCU/LED2: Q6.1 (G), R31.2, U7.3 (PC14)
/MCU/LED3: Q7.1 (G), R32.2, U7.2 (PC13)
/MCU/NRST: C29.1, IC5.1 (NO_1), IC5.2 (NO_2), J6.10 (RESET), R24.2, U7.7 (NRST)
/MCU/SCL: R25.2, U7.42 (PB6), U8.6 (SCL), U9.2 (SCL); also elsewhere on the board
/MCU/SDA: R26.2, U7.43 (PB7), U8.5 (SDA), U9.1 (SDA); also elsewhere on the board
/MCU/SWCLK: J6.04 (SWCLK), U7.37 (PA14)
/MCU/SWDIO: J6.02 (SWDIO), U7.34 (PA13)
/MCU/UART_USB_RX: U7.31 (PA10); also elsewhere on the board
/MCU/UART_USB_TX: U7.30 (PA9); also elsewhere on the board
/MCU/VDDA: C27.1, C28.1, FB2.1, U7.9 (VDDA)
GND: C22.2, C23.2, C24.2, C25.2, C26.2, C27.2, C28.2, C29.2, C30.2, C31.2, IC5.3 (COM_1), IC5.4 (COM_2), J6.03 (GND), J6.05 (GND), J6.09 (GND), Q5.2 (S), Q6.2 (S), Q7.2 (S), R23.1, R30.1, R31.1, R32.1, U7.8 (VSSA), U7.23 (VSS), U7.35 (VSS), U7.47 (VSS), U8.1 (A0), U8.2 (A1), U8.3 (A2), U8.4 (GND), U8.7 (WP), U9.4 (GND), U9.5 (A2), U9.6 (A1), U9.7 (A0); also elsewhere on the board
unnamed: D14.1 (K), R27.1
unnamed: D15.1 (K), R28.1
unnamed: D16.1 (K), R29.1
unnamed: Q5.3 (D), R27.2
unnamed: Q6.3 (D), R28.2
unnamed: Q7.3 (D), R29.2
unnamed: R23.2, U7.44 (BOOT0)

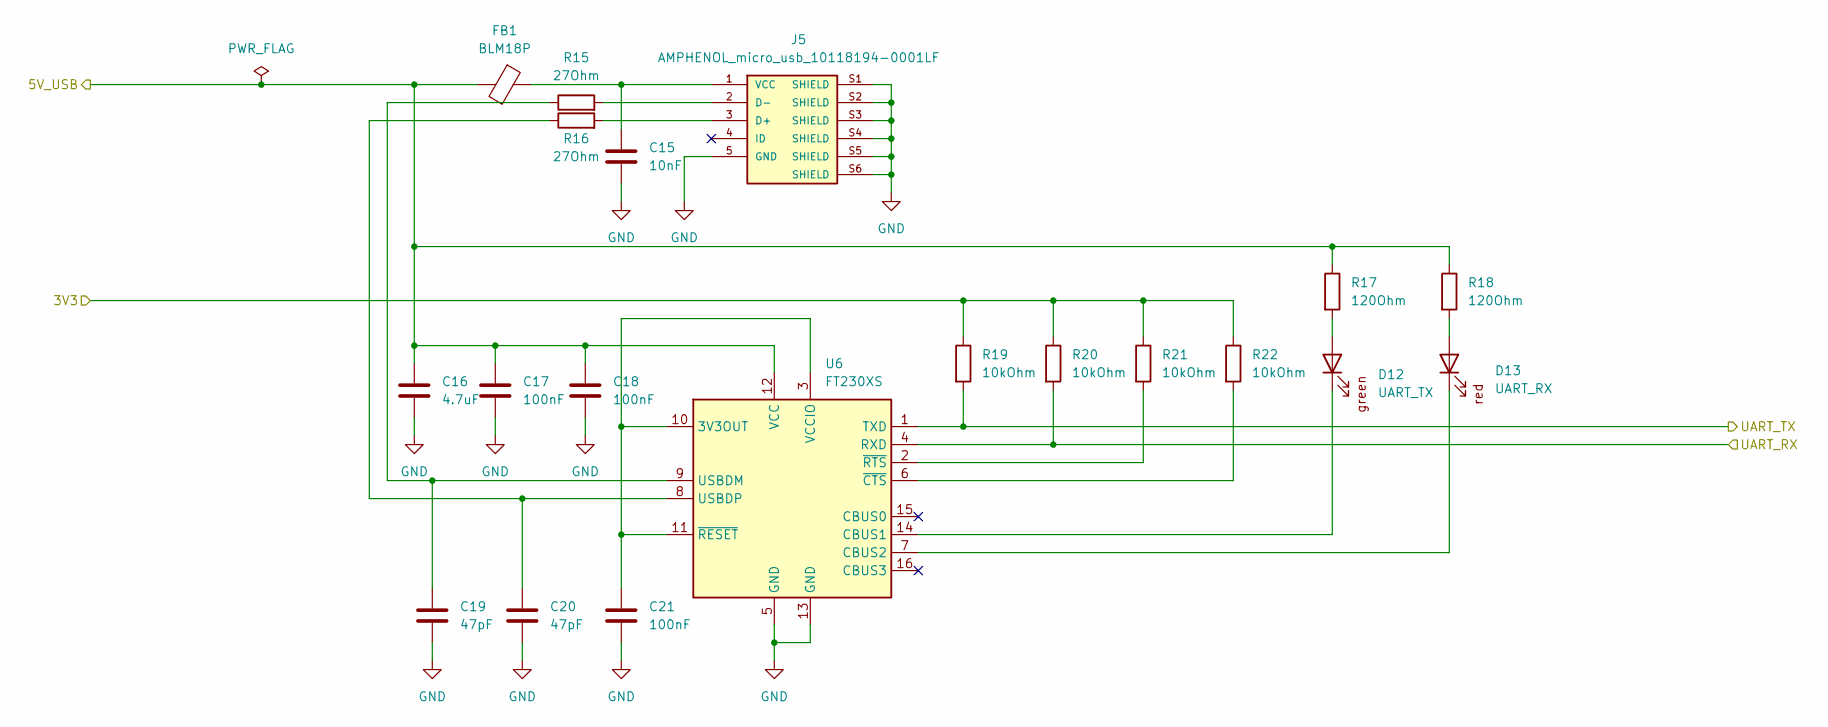
[picture p11: schematic usb.kicad_sch]

Parts:
C15: 10nF; C_0603_1608Metric_Pad1.08x0.95mm_HandSolder; Mouser Part Number 80-C0603C103M5R3121
C16: 4.7uF; C_0805_2012Metric_Pad1.18x1.45mm_HandSolder; Mouser Part Number 187-CL21A475KBQNNNE
C17, C18, C21: 100nF; C_0603_1608Metric_Pad1.08x0.95mm_HandSolder; Mouser Part Number 581-KGM15BR71H104KM
C19, C20: 47pF; C_0603_1608Metric_Pad1.08x0.95mm_HandSolder; Mouser Part Number 791-0603N470J101CT
D12: UART_TX; D_0603_1608Metric_Pad1.05x0.95mm_HandSolder; Mouser Part Number 604-AP1608SGC
D13: UART_RX; D_0603_1608Metric_Pad1.05x0.95mm_HandSolder; Mouser Part Number 859-LTST-C190KDKT10A
FB1: BLM18P; R_0603_1608Metric_Pad0.98x0.95mm_HandSolder; Mouser Part Number 81-BLM11P300S
J5: AMPHENOL_micro_usb_10118194-0001LF; AMPHENOL_10118194-0001LF; Mouser Part Number 649-10118194-0001LF
R15, R16: 27Ohm; R_0603_1608Metric_Pad0.98x0.95mm_HandSolder; Mouser Part Number 603-RC0603FR-0727RL
R17, R18: 120Ohm; R_0603_1608Metric_Pad0.98x0.95mm_HandSolder; Mouser Part Number 603-RC0603FR-07120RL
R19, R20, R21, R22: 10kOhm; R_0603_1608Metric_Pad0.98x0.95mm_HandSolder; Mouser Part Number 652-CR0603FX-1002ELF
U6: FT230XS; SSOP-16_3.9x4.9mm_P0.635mm; Mouser Part Number 895-FT230XS-R

Connections:
/3V3: R19.1, R20.1, R21.1, R22.1; also elsewhere on the board
/5V_USB: C16.1, C17.1, C18.1, FB1.2, R17.1, R18.1, U6.12 (VCC); also elsewhere on the board
/MCU/UART_USB_RX: R19.2, U6.1 (TXD); also elsewhere on the board
/MCU/UART_USB_TX: R20.2, U6.4 (RXD); also elsewhere on the board
GND: C15.2, C16.2, C17.2, C18.2, C19.2, C20.2, C21.2, J5.5 (GND), J5.S1 (SHIELD), J5.S2 (SHIELD), J5.S3 (SHIELD), J5.S4 (SHIELD), J5.S5 (SHIELD), J5.S6 (SHIELD), U6.5 (GND), U6.13 (GND); also elsewhere on the board
unnamed: D12.2 (A), R17.2
unnamed: D12.1 (K), U6.14 (CBUS1)
unnamed: D13.2 (A), R18.2
unnamed: D13.1 (K), U6.7 (CBUS2)
unnamed: J5.3 (D+), R16.2
unnamed: J5.2 (D-), R15.2
unnamed: C15.1, FB1.1, J5.1 (VCC)
unnamed: C21.1, U6.3 (VCCIO), U6.10 (3V3OUT), U6.11 (~RESET)
unnamed: C19.1, R15.1, U6.9 (USBDM)
unnamed: C20.1, R16.1, U6.8 (USBDP)
unnamed: R22.2, U6.6 (~CTS)
unnamed: R21.2, U6.2 (~RTS)
