benediktibk/battery-system/hardware/battery-management-system/battery-management-system.kicad_pcb

## KiCad design hardware/battery-management-system/battery-management-system.kicad_pcb (continued)

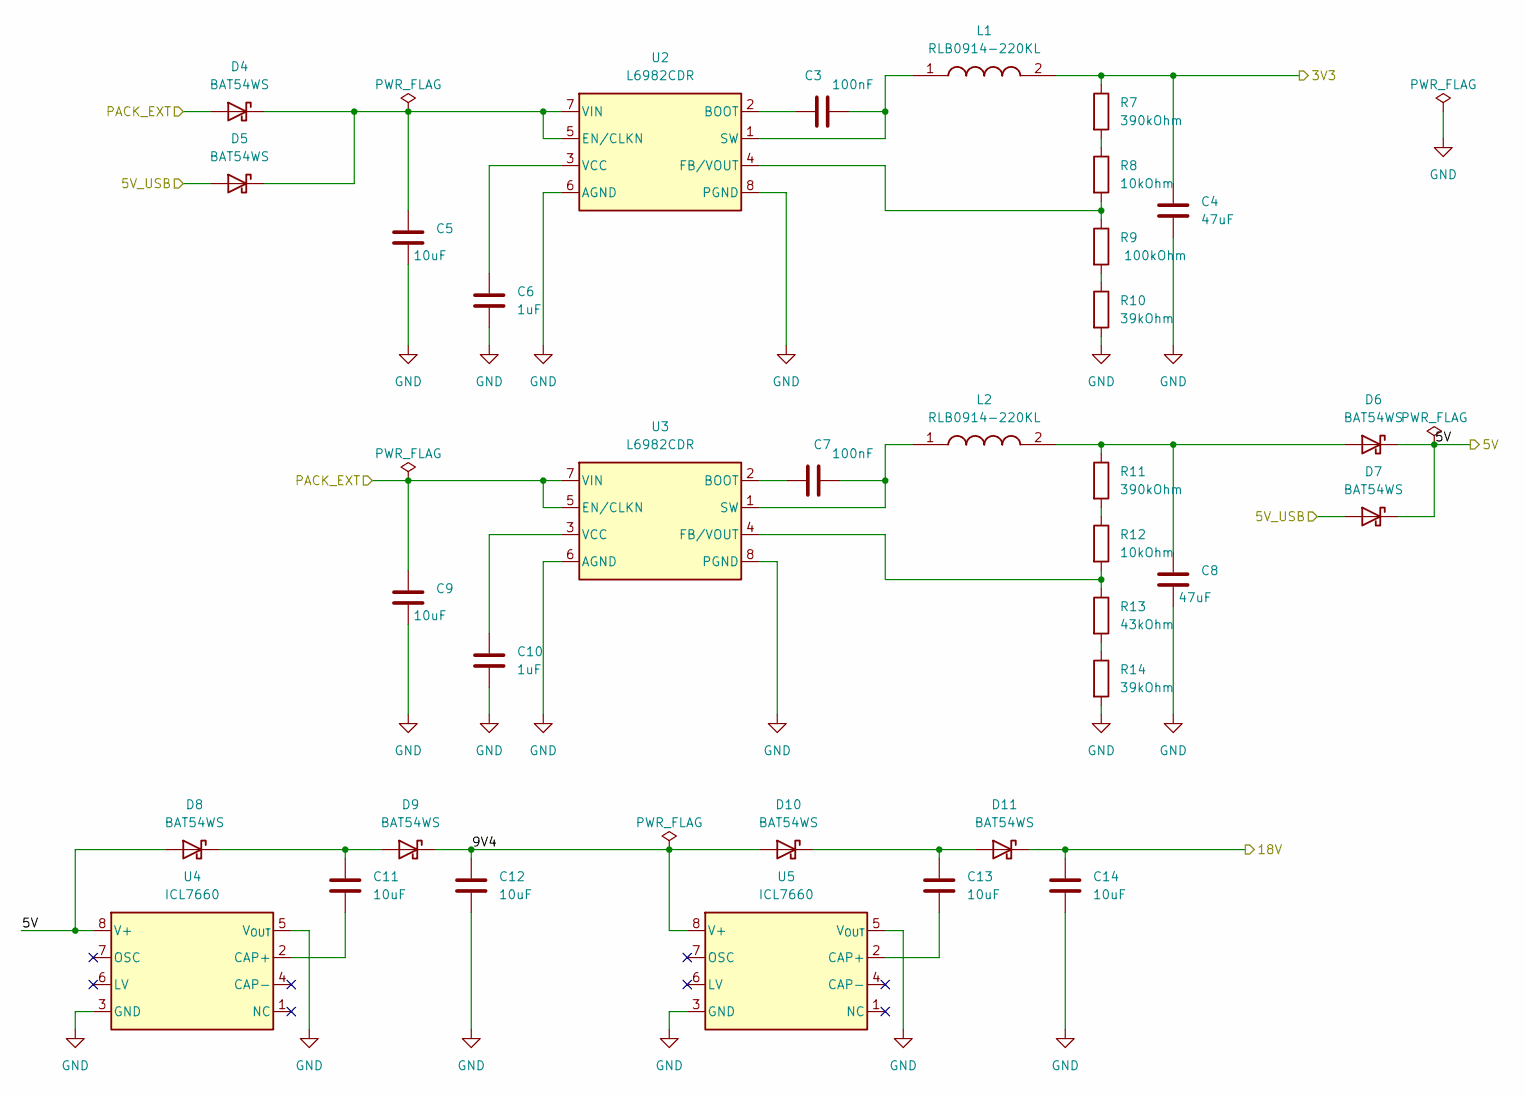
[picture p12: schematic power_supply.kicad_sch]

Parts:
C3, C7: 100nF; C_0603_1608Metric_Pad1.08x0.95mm_HandSolder; Mouser Part Number 581-KGM15BR71H104KM
C4, C8: 47uF; C_1206_3216Metric_Pad1.33x1.80mm_HandSolder; Mouser Part Number 810-C3216X5R1E476M
C5, C9, C11, C12, C13, C14: 10uF; C_1210_3225Metric_Pad1.33x2.70mm_HandSolder; Mouser Part Number 187-CL31A106MBHNNNE
C6, C10: 1uF; C_0603_1608Metric_Pad1.08x0.95mm_HandSolder; Mouser Part Number 963-UMK107BJ105KA-T
D4, D5, D6, D7, D8, D9, D10, D11: BAT54WS; D_SOD-323; Mouser Part Number 637-BAT54WS
L1, L2: RLB0914-220KL; RLB0914220KL; Mouser Part Number 652-RLB0914-220KL
R7, R11: 390kOhm; R_0603_1608Metric_Pad0.98x0.95mm_HandSolder; Mouser Part Number 603-RT0603FRE07390KL
R8, R12: 10kOhm; R_0603_1608Metric_Pad0.98x0.95mm_HandSolder; Mouser Part Number 652-CR0603FX-1002ELF
R9: 100kOhm; R_0603_1608Metric_Pad0.98x0.95mm_HandSolder; Mouser Part Number 603-RT0603FRE13100KL
R10, R14: 39kOhm; R_0603_1608Metric_Pad0.98x0.95mm_HandSolder; Mouser Part Number 603-RC0603FR-1039KL
R13: 43kOhm; R_0603_1608Metric_Pad0.98x0.95mm_HandSolder; Mouser Part Number 603-RT0603FRE0743KL
U2, U3: L6982CDR; SO-8_3.9x4.9mm_P1.27mm; Mouser Part Number 511-L6982CDR
U4, U5: ICL7660; SOIC-8_3.9x4.9mm_P1.27mm; Mouser Part Number 968-ICL7660CBAZ-T

Connections:
/3V3: C4.1, L1.2, R7.1; also elsewhere on the board
/5V: D6.1 (K), D7.1 (K), D8.2 (A), U4.8 (V+); also elsewhere on the board
/5V_USB: D5.2 (A), D7.2 (A); also elsewhere on the board
/18V: C14.1, D11.1 (K); also elsewhere on the board
/PACK_EXT: C9.1, D4.2 (A), U3.5 (EN/CLKN), U3.7 (VIN); also elsewhere on the board
/Power Supply/9V4: C12.1, D9.1 (K), D10.2 (A), U5.8 (V+)
GND: C4.2, C5.2, C6.2, C8.2, C9.2, C10.2, C12.2, C14.2, R10.2, R14.2, U2.6 (AGND), U2.8 (PGND), U3.6 (AGND), U3.8 (PGND), U4.3 (GND), U4.5 (V_{OUT}), U5.3 (GND), U5.5 (V_{OUT}); also elsewhere on the board
unnamed: C5.1, D4.1 (K), D5.1 (K), U2.5 (EN/CLKN), U2.7 (VIN)
unnamed: C8.1, D6.2 (A), L2.2, R11.1
unnamed: C11.1, D8.1 (K), D9.2 (A)
unnamed: C13.1, D10.1 (K), D11.2 (A)
unnamed: R7.2, R8.1
unnamed: R9.2, R10.1
unnamed: R11.2, R12.1
unnamed: R13.2, R14.1
unnamed: C3.2, U2.2 (BOOT)
unnamed: R8.2, R9.1, U2.4 (FB/VOUT)
unnamed: C3.1, L1.1, U2.1 (SW)
unnamed: C6.1, U2.3 (VCC)
unnamed: C7.2, U3.2 (BOOT)
unnamed: R12.2, R13.1, U3.4 (FB/VOUT)
unnamed: C7.1, L2.1, U3.1 (SW)
unnamed: C10.1, U3.3 (VCC)
unnamed: C11.2, U4.2 (CAP+)
unnamed: C13.2, U5.2 (CAP+)

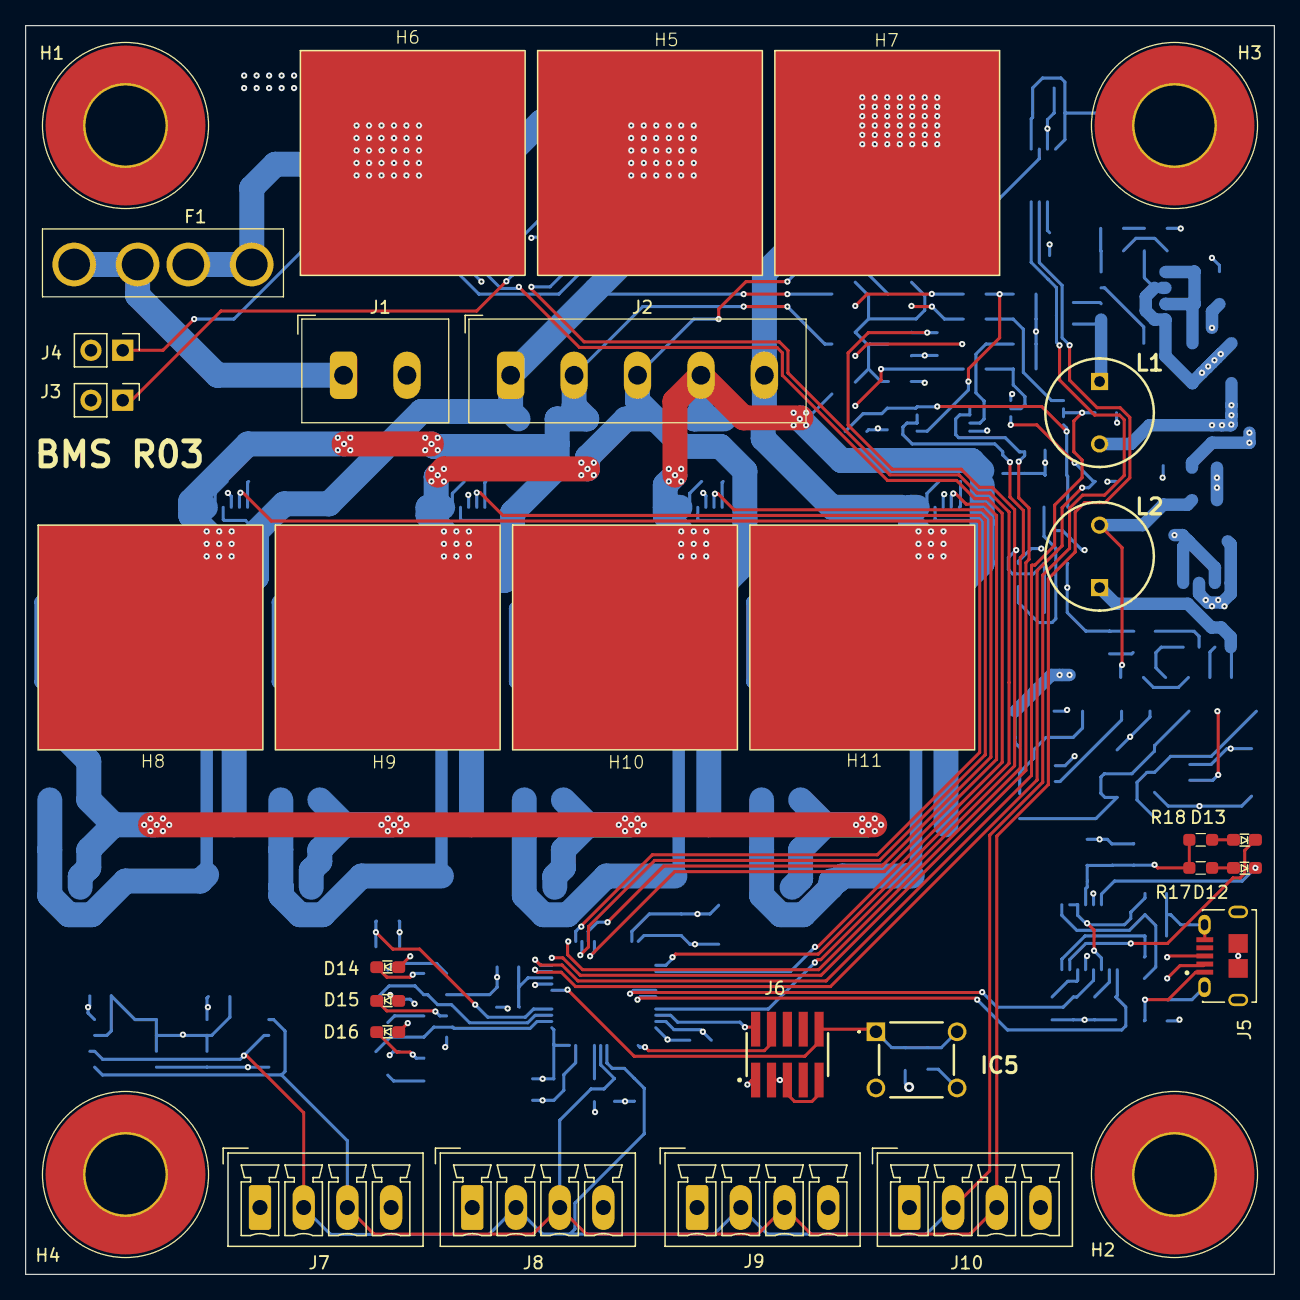
[picture p13: board battery-management-system.kicad_pcb from above]

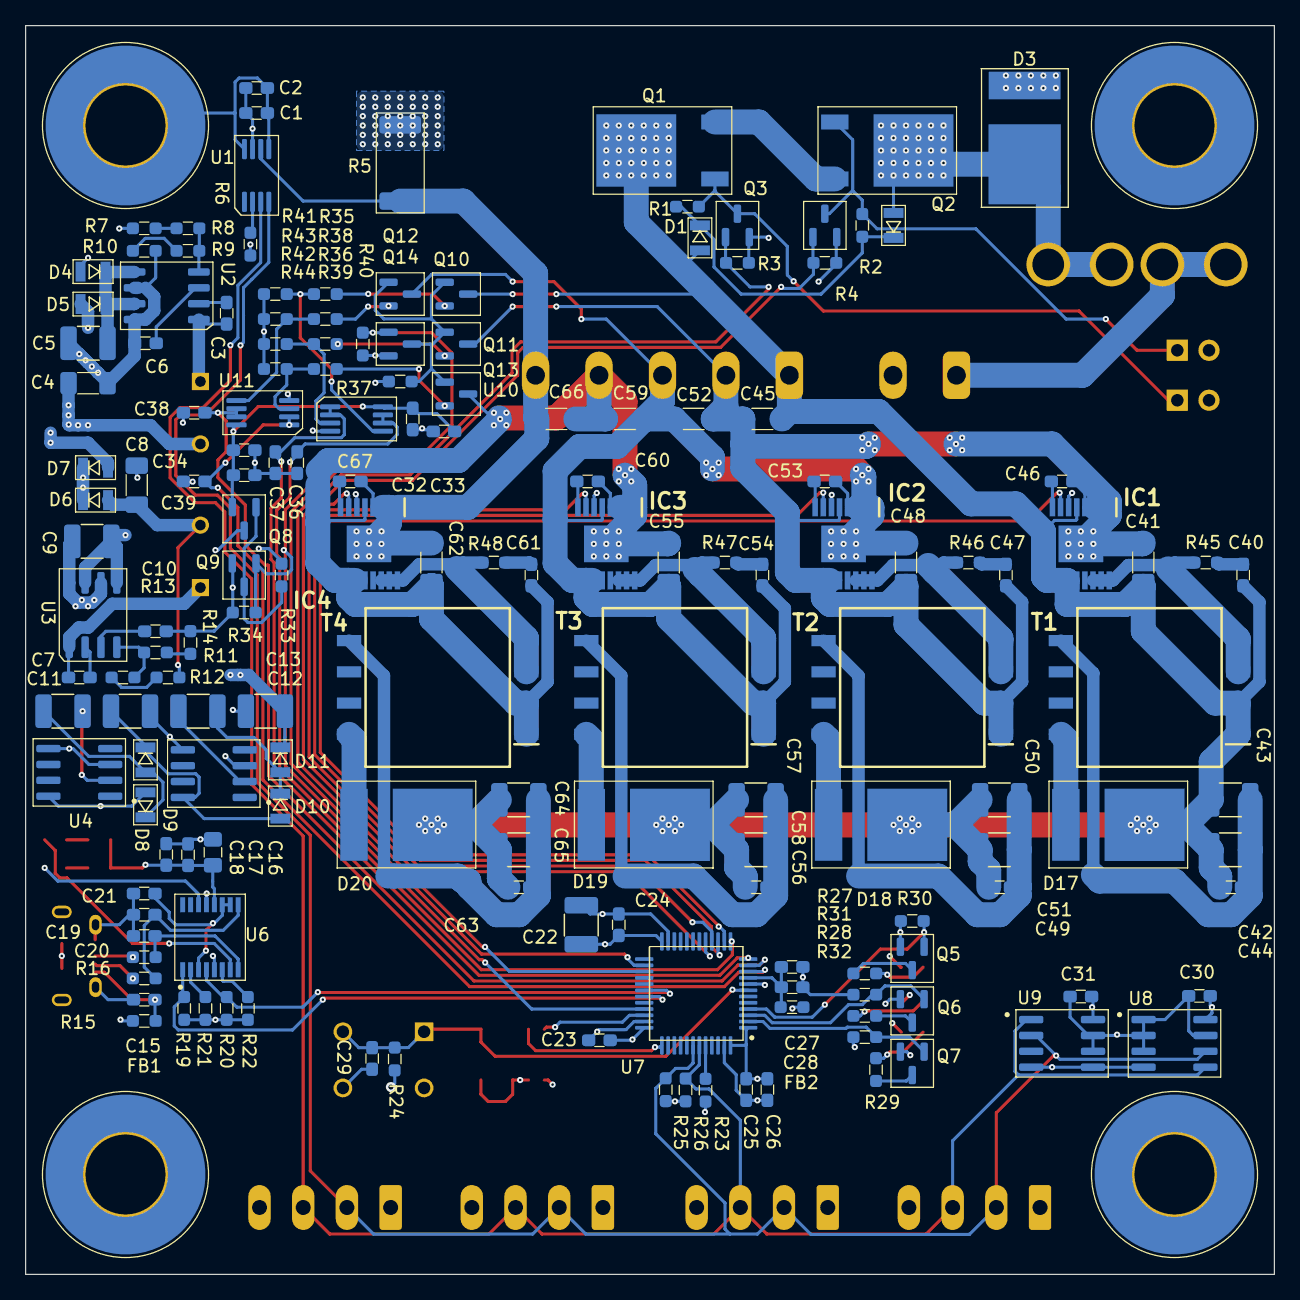
[picture p14: board battery-management-system.kicad_pcb from below]

Board: 4 copper layers, 100.0 x 100.0 mm, 195 parts (163 on the bottom side), 108 nets.
