benediktibk/battery-system/hardware/cell-temperature-sensor/cell-temperature-sensor.kicad_pcb

## KiCad design hardware/cell-temperature-sensor/cell-temperature-sensor.kicad_pcb (2025-03-11)

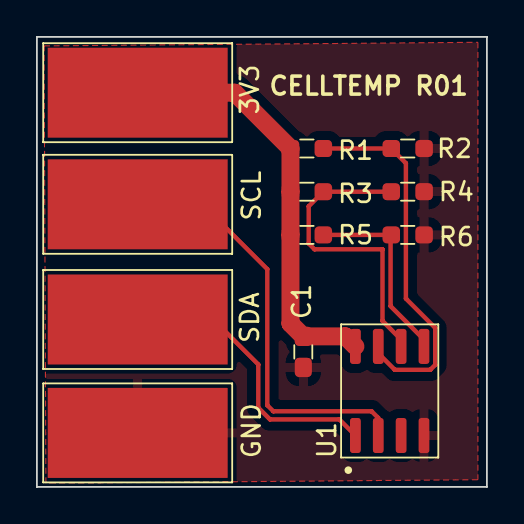
[picture p15: board cell-temperature-sensor.kicad_pcb from above]

Board: 2 copper layers, 25.0 x 25.0 mm, 12 parts (0 on the bottom side), 7 nets.

Parts:
C1: 100nF; C_0603_1608Metric_Pad1.08x0.95mm_HandSolder
J1: 3V3; SolderWirePad_1x01_SMD_5x10mm
J2: SCL; SolderWirePad_1x01_SMD_5x10mm
J3: SDA; SolderWirePad_1x01_SMD_5x10mm
J4: GND; SolderWirePad_1x01_SMD_5x10mm
R1, R2, R3, R4, R5, R6: 100kOhm; R_0603_1608Metric_Pad0.98x0.95mm_HandSolder
U1: NCT75DR2G; SOIC-8_3.9x4.9mm_P1.27mm

Connections:
/3V3: C1.1, J1.1, R1.1, R3.1, R5.1, U1.8 (V_{CC})
/SCL: J2.1, U1.2 (SCL)
/SDA: J3.1, U1.1 (SDA)
GND: C1.2, J4.1, R2.2, R4.2, R6.2, U1.4 (GND)
unnamed: R1.2, R2.1, U1.7 (A0)
unnamed: R3.2, R4.1, U1.6 (A1)
unnamed: R5.2, R6.1, U1.5 (A2)
