benediktibk/battery-system/hardware/dc-dc-converter-24v/dc-dc-converter-24v.kicad_pcb

## KiCad design hardware/dc-dc-converter-24v/dc-dc-converter-24v.kicad_pcb (2025-03-11)

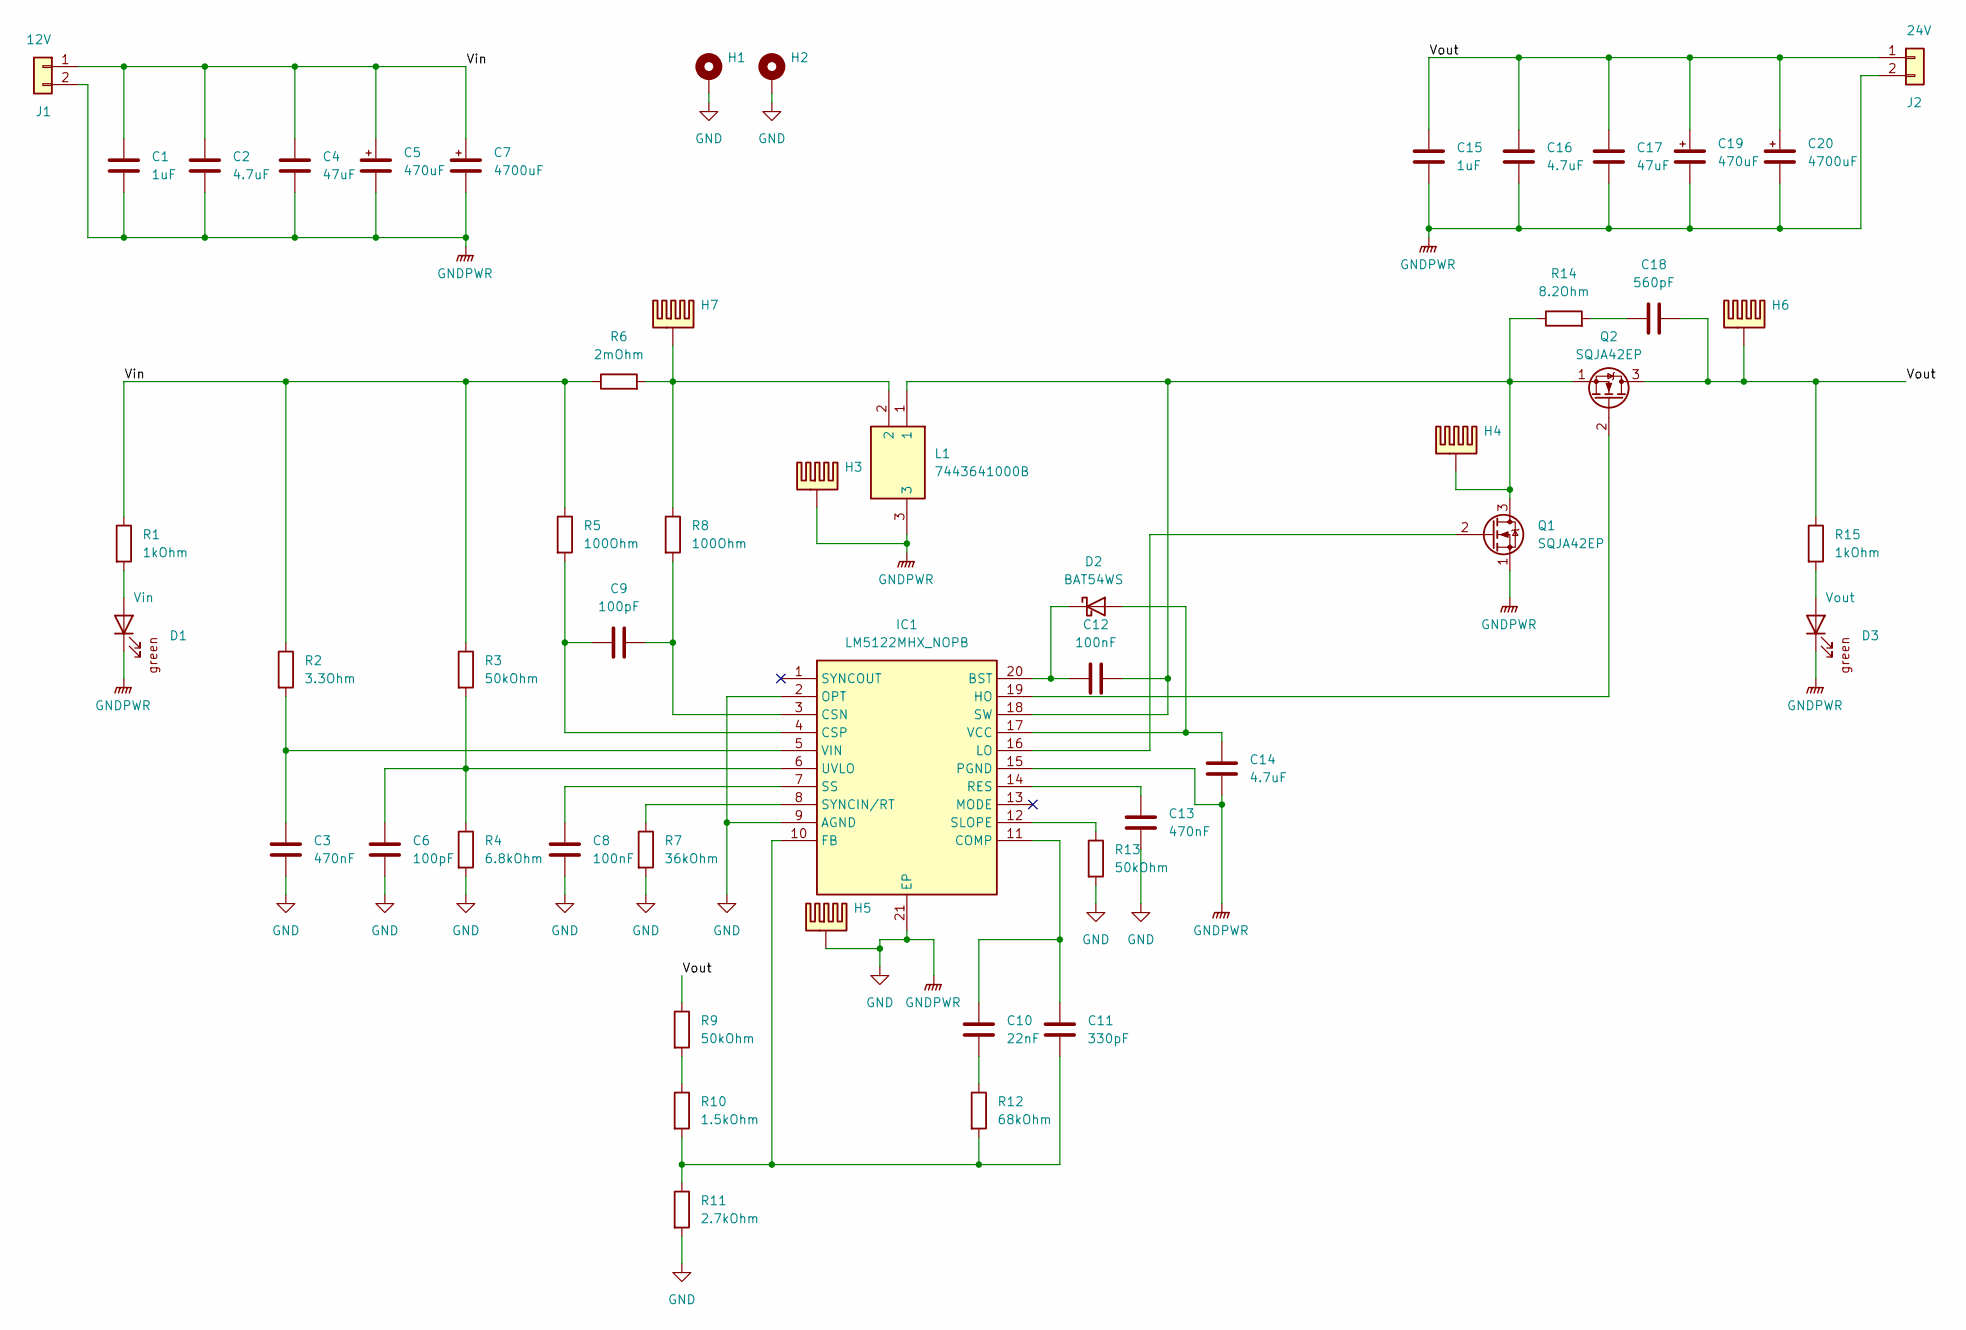
[picture p16: schematic dc-dc-converter-24v.kicad_sch]

Parts:
C1, C15: 1uF; C_0603_1608Metric_Pad1.08x0.95mm_HandSolder; Mouser Part Number 963-UMK107BJ105KA-T
C2, C14, C16: 4.7uF; C_0805_2012Metric_Pad1.18x1.45mm_HandSolder; Mouser Part Number 187-CL21A475KBQNNNE
C3, C13: 470nF; C_0603_1608Metric_Pad1.08x0.95mm_HandSolder; Mouser Part Number 963-TMK107B7474KA-TR
C4, C17: 47uF; C_1206_3216Metric_Pad1.33x1.80mm_HandSolder; Mouser Part Number 810-C3216X5R1E476M
C5, C19: 470uF; PCAP_16x16_5-ELECT_NCA-M; Mouser Part Number 647-UCD1J471MNQ1MS; Mouser order number 647-UCD1J471MNQ1MS
C6, C9: 100pF; C_0603_1608Metric_Pad1.08x0.95mm_HandSolder; Mouser Part Number 80-C0603C101K5GACLR
C7, C20: 4700uF; CP_Radial_D22.0mm_P10.00mm_SnapIn; Mouser Part Number 80-ESK478M050AQ3AA; Mouser order number 80-ESK478M050AQ3AA
C8, C12: 100nF; C_0603_1608Metric_Pad1.08x0.95mm_HandSolder; Mouser Part Number 581-KGM15BR71H104KM
C10: 22nF; C_0603_1608Metric_Pad1.08x0.95mm_HandSolder; Mouser Part Number 80-C0603C223K4R
C11: 330pF; C_0603_1608Metric_Pad1.08x0.95mm_HandSolder; Mouser Part Number 791-0603N331J500CT
C18: 560pF; C_0603_1608Metric_Pad1.08x0.95mm_HandSolder; Mouser Part Number 77-VJ0603A561JXAAC
D1: Vin; D_0603_1608Metric_Pad1.05x0.95mm_HandSolder; Mouser Part Number 604-AP1608SGC
D2: BAT54WS; D_SOD-323; Mouser Part Number 637-BAT54WS
D3: Vout; D_0603_1608Metric_Pad1.05x0.95mm_HandSolder; Mouser Part Number 604-AP1608SGC
H1, H2: MountingHole_Pad_M6; MountingHole_6.4mm_M6_Pad_TopBottom
H3, H4, H5, H6, H7: heatsink_18x18; Mouser Part Number 490-HSB06-181810; Mouser order number 490-HSB06-181810
IC1: LM5122MHX_NOPB; SOP65P640X110-21N; Mouser Part Number 595-LM5122MHX/NOPB
J1: 12V; rspro_header_2pin_5_08mm
J2: 24V; rspro_header_2pin_5_08mm
L1: 7443641000B; Mouser Part Number 710-7443641000B
Q1, Q2: SQJA42EP; SQJA42EPT1_GE3; Mouser Part Number 78-SQJA42EP-T1_GE3
R1, R15: 1kOhm; R_0603_1608Metric_Pad0.98x0.95mm_HandSolder; Mouser Part Number 603-RC0603FR-101KL
R2: 3.3Ohm; R_0603_1608Metric_Pad0.98x0.95mm_HandSolder; Mouser Part Number 603-RT0603BRD073R3L
R3, R9, R13: 50kOhm; R_0603_1608Metric_Pad0.98x0.95mm_HandSolder; Mouser Part Number 603-RT0603BRD0750KL
R4: 6.8kOhm; R_0603_1608Metric_Pad0.98x0.95mm_HandSolder; Mouser Part Number 594-MCT0603ME6801BP5
R5, R8: 100Ohm; R_0603_1608Metric_Pad0.98x0.95mm_HandSolder; Mouser Part Number 279-CRGH0603F100R
R6: 2mOhm; R_2512_6332Metric_Pad1.40x3.35mm_HandSolder; Mouser Part Number 660-TLR3APSDTE2L00F7
R7: 36kOhm; R_0603_1608Metric_Pad0.98x0.95mm_HandSolder; Mouser Part Number 652-CR0603FX-3602ELF
R10: 1.5kOhm; R_0603_1608Metric_Pad0.98x0.95mm_HandSolder; Mouser Part Number 667-ERA-3APB152V
R11: 2.7kOhm; R_0603_1608Metric_Pad0.98x0.95mm_HandSolder; Mouser Part Number 667-ERA-3ARB272V
R12: 68kOhm; R_0603_1608Metric_Pad0.98x0.95mm_HandSolder; Mouser Part Number 603-RT0603FRE0768KL
R14: 8.2Ohm; R_0603_1608Metric_Pad0.98x0.95mm_HandSolder; Mouser Part Number 660-RK73B1JTTD8R2J

Connections:
/Vin: C1.1, C2.1, C4.1, C5.1, C7.1, J1.1, R1.1, R2.1, R3.1, R5.1, R6.1
/Vout: C15.1, C16.1, C17.1, C18.2, C19.1, C20.1, H6.PAD, J2.1, Q2.3 (D), R9.1, R15.1
GND: C1.2, C2.2, C3.2, C4.2, C5.2, C6.2, C7.2, C8.2, C13.2, C14.2, C15.2, C16.2, C17.2, C19.2, C20.2, D1.1 (K), D3.1 (K), H1.1, H2.1, H3.PAD, H5.PAD, IC1.2 (OPT), IC1.9 (AGND), IC1.15 (PGND), IC1.21 (EP), J1.2, J2.2, L1.3, Q1.1 (S), R4.2, R7.2, R11.2, R13.2
unnamed: C10.2, R12.1
unnamed: C18.1, R14.2
unnamed: D1.2 (A), R1.2
unnamed: C14.1, D2.2 (A), IC1.17 (VCC)
unnamed: C12.1, D2.1 (K), IC1.20 (BST)
unnamed: D3.2 (A), R15.2
unnamed: H7.PAD, L1.2, R6.2, R8.1
unnamed: C10.1, C11.1, IC1.11 (COMP)
unnamed: C9.2, IC1.3 (CSN), R8.2
unnamed: C9.1, IC1.4 (CSP), R5.2
unnamed: C11.2, IC1.10 (FB), R10.2, R11.1, R12.2
unnamed: IC1.19 (HO), Q2.2 (G)
unnamed: IC1.16 (LO), Q1.2 (G)
unnamed: C13.1, IC1.14 (RES)
unnamed: IC1.12 (SLOPE), R13.1
unnamed: C8.1, IC1.7 (SS)
unnamed: C12.2, H4.PAD, IC1.18 (SW), L1.1, Q1.3 (D), Q2.1 (S), R14.1
unnamed: IC1.8 (SYNCIN/RT), R7.1
unnamed: C6.1, IC1.6 (UVLO), R3.2, R4.1
unnamed: C3.1, IC1.5 (VIN), R2.2
unnamed: R9.2, R10.1

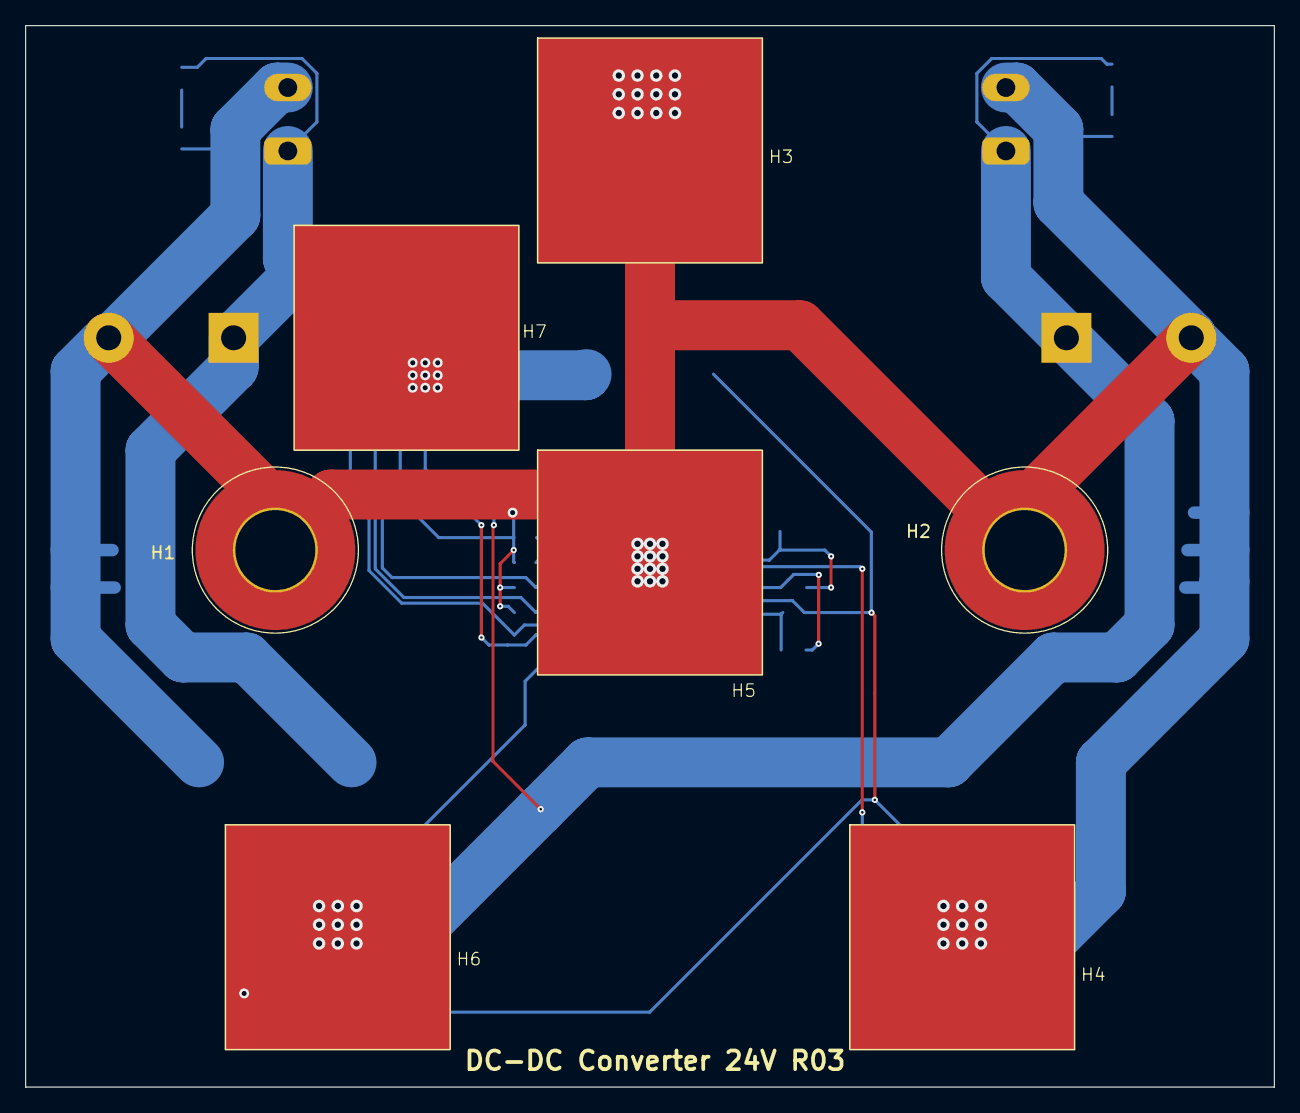
[picture p17: board dc-dc-converter-24v.kicad_pcb from above]

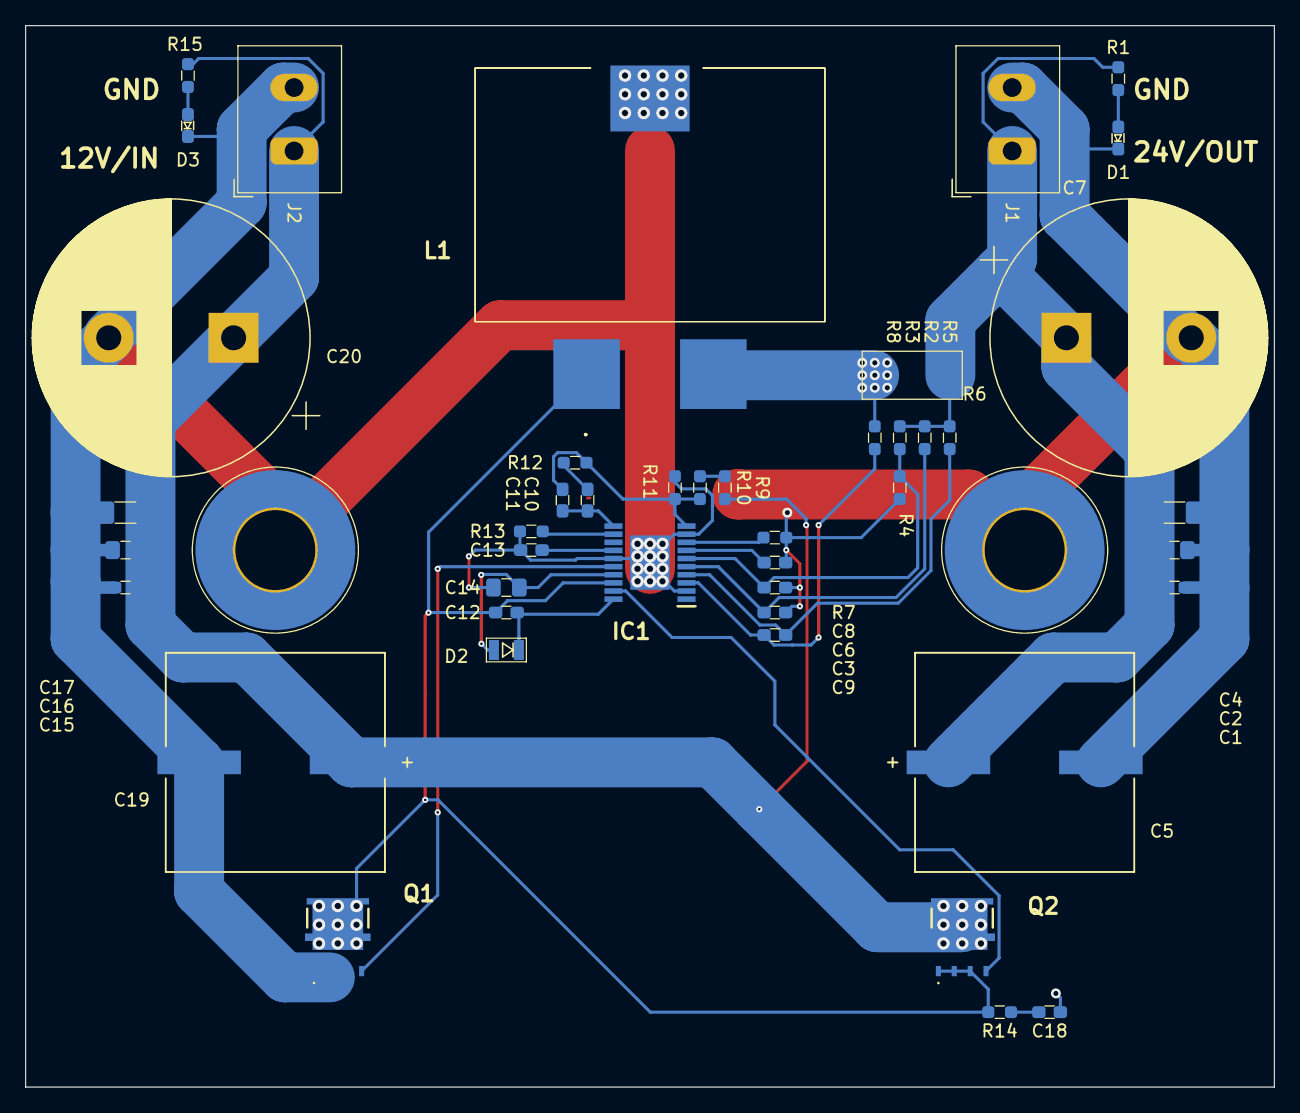
[picture p18: board dc-dc-converter-24v.kicad_pcb from below]

Board: 2 copper layers, 100.0 x 85.0 mm, 51 parts (44 on the bottom side), 24 nets.
