benediktibk/battery-system/(commit log)

2023-08-13 add initial battery management system
    [battery-management-system.kicad_pcb, battery-management-system.kicad_sch]
2023-08-13 add gitignore
    [battery-management-system.kicad_sch]
2023-08-13 add USB and debug connectors
    [battery-management-system.kicad_sch]
2023-10-15 add simulation for charge and discharge FETs
2023-10-15 add charge and discharge FETs
    [battery-management-system.kicad_sch]
2023-10-15 add calculation spread sheet
    [battery_system.ods]
2023-10-15 specify forward voltage of diode
2023-10-18 select diode for charge and discharge FETs
    [battery-management-system.kicad_sch]
2023-10-18 introduce hierarchical sheets
    [battery-management-system.kicad_sch, battery_pack.kicad_sch, interconnect.kicad_sch, mcu.kicad_sch, power_supply.kicad_sch, usb.kicad_sch]
2023-10-19 define basic hierarchy and power supplies
    [battery-management-system.kicad_sch, cell_measurement.kicad_sch, interconnect.kicad_sch, mcu.kicad_sch, power_supply.kicad_sch, usb.kicad_sch]
2023-10-20 enable 5V with VIN
    [battery-management-system.kicad_sch, power_supply.kicad_sch]
2023-10-20 add RS order numbers
    [battery-management-system.csv, battery-management-system.kicad_sch, battery_pack.kicad_sch, mcu.kicad_sch, power_supply.kicad_sch, usb.kicad_sch]
2023-10-20 add missing order numbers
    [battery-management-system.csv, battery-management-system.kicad_sch, mcu.kicad_sch, usb.kicad_sch]
2023-10-21 define current sense resistance value
    [battery-management-system.kicad_sch, battery_pack.kicad_sch]
2023-10-21 use own symbols and footprints
    [battery-management-system.csv, battery-management-system.kicad_sch, battery_pack.kicad_sch, mcu.kicad_sch, power_supply.kicad_sch, usb.kicad_sch]
2023-10-21 use correct symbol for current sense resistor
    [battery-management-system.csv, battery-management-system.kicad_sch, battery_pack.kicad_sch]
2023-10-21 specify footprints for resistors, capacitors and inductances
    [battery-management-system.csv, battery-management-system.kicad_sch, battery_pack.kicad_sch, power_supply.kicad_sch]
2023-10-21 specify footprint for 47uF capacitor
    [battery-management-system.csv, battery-management-system.kicad_sch, power_supply.kicad_sch]
2023-10-21 use M6 connectors, update symbols
    [battery-management-system.csv, battery-management-system.kicad_sch, battery_pack.kicad_sch, power_supply.kicad_sch, usb.kicad_sch]
2023-10-21 automatically import schematic into PCB
2023-10-21 add first attempt for balance FET circuit
2023-10-22 add second version of active balancing circuit
2023-10-22 update PCB
    [battery-management-system.kicad_pcb, battery-management-system.kicad_sch, battery_pack.kicad_sch]
2023-10-22 simulate balance circuit with inductor
2023-10-22 control balance fets with smaller control voltage
2023-10-22 dimension balance circuit approach with inductance
    [battery_system.ods]
2023-10-22 simulate balancing circuit with capacitor bank
2023-10-22 tune balance circuit simulation
2023-10-22 use only nmos in balance FET simulation
2023-10-22 calculate balancing with FETs
    [battery_system.ods]
2023-11-12 create schematic for USB
    [battery-management-system.kicad_sch, usb.kicad_sch]
2023-11-13 add resistors, capacitors and LEDs
    [battery-management-system.kicad_pcb, battery-management-system.kicad_sch, battery_pack.kicad_sch, charger.kicad_sch, mcu.kicad_sch, usb.kicad_sch]
2023-11-13 implement interconnect
    [battery-management-system.kicad_sch, cell_measurement.kicad_sch, interconnect.kicad_sch, mcu.kicad_sch, usb.kicad_sch]
2023-11-14 implement cell measurement
    [battery-management-system.kicad_sch, battery_pack.kicad_sch, cell_measurement.kicad_sch]
2023-11-14 route UART and ADC channels on MCU
    [battery-management-system.kicad_pcb, battery-management-system.kicad_sch, battery_pack.kicad_sch, cell_measurement.kicad_sch, interconnect.kicad_sch, mcu.kicad_sch]
2023-11-19 add power supply for MCU
    [battery-management-system.kicad_sch, battery_pack.kicad_sch, mcu.kicad_sch]
2023-11-21 add temperature sensor and LEDs
    [battery-management-system.kicad_pcb, battery-management-system.kicad_sch, battery_pack.kicad_sch, mcu.kicad_sch]
2023-11-22 calculate balancing with reed relais
    [battery_system.ods]
2023-11-22 improve calculation of balancing
    [battery_system.ods]
2023-11-23 add components
    [battery-management-system.kicad_pcb, battery-management-system.kicad_sch, battery_pack.kicad_sch, cell_measurement.kicad_sch, interconnect.kicad_sch, mcu.kicad_sch, power_supply.kicad_sch, usb.kicad_sch]
2023-11-23 improve usage of net labels
    [battery-management-system.kicad_sch, battery_pack.kicad_sch, cell_measurement.kicad_sch, mcu.kicad_sch]
2023-11-24 add 20V supply
    [cell_measurement.kicad_sch, power_supply.kicad_sch]
2023-11-24 add balancing sheet
    [battery-management-system.kicad_sch, battery_pack.kicad_sch, cell_balancing.kicad_sch, cell_measurement.kicad_sch, interconnect.kicad_sch, mcu.kicad_sch, power_supply.kicad_sch, usb.kicad_sch]
2023-11-24 implement balancing
    [battery-management-system.kicad_sch, battery_pack.kicad_sch, cell_balancing.kicad_sch, mcu.kicad_sch]
2023-11-24 add fuel gauge IC
    [battery-management-system.kicad_pcb, battery-management-system.kicad_sch, cell_balancing.kicad_sch, mcu.kicad_sch, power_supply.kicad_sch]
2023-11-24 fix electrical rule checker errors
    [cell_balancing.kicad_sch, cell_measurement.kicad_sch, mcu.kicad_sch, usb.kicad_sch]
2023-11-24 fix current sensing
    [battery-management-system.kicad_pcb, battery-management-system.kicad_sch, cell_balancing.kicad_sch, cell_measurement.kicad_sch, mcu.kicad_sch, power_supply.kicad_sch, usb.kicad_sch]
2023-11-25 add negative power supply for OPAMPs
    [battery-management-system.kicad_pcb, battery-management-system.kicad_sch, battery_system.ods, cell_balancing.kicad_sch, cell_measurement.kicad_sch, power_supply.kicad_sch]
2023-11-25 implement negative power supply for OPAMPs
    [battery-management-system.kicad_sch, cell_balancing.kicad_sch, cell_measurement.kicad_sch, power_supply.kicad_sch]
2023-11-25 fix ERC issues
    [battery_pack.kicad_sch, cell_measurement.kicad_sch, power_supply.kicad_sch]
2023-11-25 fix PCB errors
    [battery-management-system.kicad_pcb, battery_pack.kicad_sch, cell_balancing.kicad_sch, power_supply.kicad_sch]
2023-11-25 improve placement
    [battery-management-system.kicad_pcb, battery-management-system.kicad_sch, battery_pack.kicad_sch]
2023-11-26 place and route
    [battery-management-system.kicad_pcb, battery_pack.kicad_sch, cell_balancing.kicad_sch, power_supply.kicad_sch]
2023-11-27 retry layout
    [battery-management-system.kicad_pcb]
2023-11-27 start with routing of USB
    [battery-management-system.kicad_pcb]
2023-11-27 route USB
    [battery-management-system.kicad_pcb]
2023-11-27 route power routes
    [battery-management-system.kicad_pcb]
2023-11-27 place balance caps and relais
    [battery-management-system.kicad_pcb]
2023-11-27 work on layout
    [battery-management-system.kicad_pcb]
2023-11-27 finish first draft of layout
    [battery-management-system-B_Cu.gbr, battery-management-system-B_Mask.gbr, battery-management-system-B_Paste.gbr, battery-management-system-B_Silkscreen.gbr, battery-management-system-Edge_Cuts.gbr, battery-management-system-F_Cu.gbr, battery-management-system-F_Mask.gbr, battery-management-system-F_Paste.gbr]
2023-11-29 fix design rule errors
    [battery-management-system.kicad_pcb]
2023-11-30 update mounting hole footpring
    [battery-management-system.kicad_pcb]
2023-11-30 update ignore settings
    [battery-management-system.kicad_pcb]
2023-12-01 apply recommendations of Stefan
    [battery-management-system.kicad_pcb, cell_measurement.kicad_sch, mcu.kicad_sch]
2023-12-01 remove net classes
    [battery_pack.kicad_sch, power_supply.kicad_sch]
2023-12-01 improve silkscreen
2023-12-01 improve layout
    [battery-management-system.kicad_pcb, battery-management-system.kicad_sch, battery_pack.kicad_sch, cell_balancing.kicad_sch, cell_measurement.kicad_sch, interconnect.kicad_sch, mcu.kicad_sch, power_supply.kicad_sch]
2023-12-02 improve fabrication layers
    [battery-management-system.kicad_pcb]
2023-12-02 finish routing
    [battery-management-system.kicad_pcb, mcu.kicad_sch]
2023-12-02 improve silkscreen and fab
    [battery-management-system.kicad_pcb, battery_pack.kicad_sch]
2023-12-02 add label and version to silkscreen
    [battery-management-system-B_Courtyard.gbr, battery-management-system-B_Cu.gbr, battery-management-system-B_Silkscreen.gbr, battery-management-system-Edge_Cuts.gbr, battery-management-system-F_Courtyard.gbr, battery-management-system-F_Cu.gbr, battery-management-system-F_Silkscreen.gbr, battery-management-system-Gnd_Cu.gbr]
2023-12-02 add cell temperature sensor PCB
    [cell-temperature-sensor-B_Cu.gbr, cell-temperature-sensor-B_Mask.gbr, cell-temperature-sensor-B_Paste.gbr, cell-temperature-sensor-B_Silkscreen.gbr, cell-temperature-sensor-Edge_Cuts.gbr, cell-temperature-sensor-F_Cu.gbr, cell-temperature-sensor-F_Mask.gbr, cell-temperature-sensor-F_Paste.gbr]
2023-12-02 add project for DC DC converter PCB
    [battery-management-system.csv, cell-temperature-sensor.csv, cell_balancing.kicad_sch, dc-dc-converter-24v.kicad_pcb, dc-dc-converter-24v.kicad_sch, mcu.kicad_sch]
2023-12-02 add 3D model of supercap
    [battery-management-system.kicad_pcb]
2023-12-03 update footprints and layout
    [battery-management-system.kicad_pcb, cell_balancing.kicad_sch]
2023-12-04 update BOM
    [battery-management-system.csv]
2023-12-13 add option for balancing with an inductor
    [battery_system.ods]
2023-12-13 add another option for balancing with an inductor
    [battery_system.ods]
2023-12-26 simplify cell measurement
    [battery-management-system.kicad_sch, cell_measurement.kicad_sch, power_supply.kicad_sch]
2023-12-26 develop inductance based balance methods
    [battery-management-system.kicad_sch, battery_system.ods]
2023-12-28 switch to inductor based cell balancing
    [battery_pack.kicad_sch, cell_balancing.kicad_sch, cell_measurement.kicad_sch, mcu.kicad_sch]
2023-12-29 finish cell balancing changes
    [battery-management-system.kicad_sch, battery_system.ods, cell_balancing.kicad_sch, mcu.kicad_sch]
2023-12-29 fix electrical rule check errors
    [battery-management-system.kicad_sch, cell_balancing.kicad_sch, cell_measurement.kicad_sch, mcu.kicad_sch, power_supply.kicad_sch]
2023-12-29 add enable input for cell measurement
    [battery-management-system.kicad_pcb, battery-management-system.kicad_sch, battery_pack.kicad_sch, cell_balancing.kicad_sch, cell_measurement.kicad_sch, interconnect.kicad_sch, mcu.kicad_sch, power_supply.kicad_sch]
2023-12-29 make layout easier for cell measurement
    [battery-management-system.kicad_pcb, cell_balancing.kicad_sch, cell_measurement.kicad_sch, temperature_sensors.kicad_sch]
2023-12-29 finish layout of cell measurement
    [battery-management-system.kicad_pcb, power_supply.kicad_sch]
2023-12-29 finish placement and layout of supplies
    [battery-management-system.kicad_pcb]
2023-12-29 place and partial route USB
    [battery-management-system.kicad_pcb]
2023-12-29 add overrides for charge and discharge
    [battery-management-system.kicad_pcb, battery_pack.kicad_sch]
2023-12-29 place USB again
    [battery-management-system.kicad_pcb]
2023-12-29 continue with layout
    [battery-management-system.kicad_pcb]
2023-12-30 improve routing of power supply
    [battery-management-system.kicad_pcb]
2023-12-30 generate fabrication outputs
    [battery-management-system-B_Courtyard.gbr, battery-management-system-B_Cu.gbr, battery-management-system-B_Silkscreen.gbr, battery-management-system-Edge_Cuts.gbr, battery-management-system-F_Courtyard.gbr, battery-management-system-F_Cu.gbr, battery-management-system-F_Silkscreen.gbr, battery-management-system-Gnd_Cu.gbr]
2023-12-30 fix silkscreen
    [battery-management-system.kicad_pcb]
2023-12-30 improve fab layers
    [battery-management-system.kicad_pcb]
2023-12-30 create fabrication outputs for R01
    [battery-management-system-B_Courtyard.gbr, battery-management-system-B_Cu.gbr, battery-management-system-B_Mask.gbr, battery-management-system-B_Paste.gbr, battery-management-system-B_Silkscreen.gbr, battery-management-system-Edge_Cuts.gbr, battery-management-system-F_Courtyard.gbr, battery-management-system-F_Cu.gbr]
2023-12-30 update R01 fabrication outputs of celltemperature sensor and battery-management-system
    [cell-temperature-sensor-B_Cu.gbr, cell-temperature-sensor-B_Mask.gbr, cell-temperature-sensor-B_Paste.gbr, cell-temperature-sensor-B_Silkscreen.gbr, cell-temperature-sensor-Edge_Cuts.gbr, cell-temperature-sensor-F_Cu.gbr, cell-temperature-sensor-F_Mask.gbr, cell-temperature-sensor-F_Paste.gbr]
2024-01-02 start with DC-DC converter
    [battery-management-system.kicad_pcb, dc-dc-converter-24v.kicad_sch]
2024-01-02 update symbol in DC-DC converter
    [dc-dc-converter-24v.kicad_sch]
2024-02-16 rename devices in BMS
2024-02-18 add list of design errors for BMS R01
2024-02-18 work on DC DC converter
    [boost_converter_12V_24V.ods, dc-dc-converter-24v.kicad_sch]
2024-02-18 continue with design of DC-DC converter
    [boost_converter_12V_24V.ods, dc-dc-converter-24v.kicad_sch]
2024-02-21 select MOSFETs for DC-DC converter
    [boost_converter.kicad_sch, boost_converter_12V_24V.ods, dc-dc-converter-24v.kicad_sch, output_filter.kicad_sch]
2024-02-21 improve output filter of DC-DC converter
    [boost_converter.kicad_sch, output_filter.kicad_sch]
2024-02-21 update symbols and footprints
    [boost_converter.kicad_sch, dc-dc-converter-24v.kicad_pcb, output_filter.kicad_sch]
2024-02-26 add edge cuts
    [dc-dc-converter-24v.kicad_pcb]
2024-03-11 move hardware into dedicated folder
    [battery-management-system.csv, battery-management-system.kicad_pcb, battery-management-system.kicad_sch, battery_pack.kicad_sch, boost_converter.kicad_sch, cell-temperature-sensor.csv, cell-temperature-sensor.kicad_pcb, cell-temperature-sensor.kicad_sch]
2024-03-12 add basics for board of battery management system
2024-03-15 fix build of battery management system
    [main.c]
2024-03-26 add script for flashing with black magic probe
2024-03-26 implement status leds
2024-03-26 configure status LEDs during startup in main
2024-03-26 activate interconnect UART
2024-03-26 activate I2C
2024-03-28 implement cell voltage measurement
2024-03-28 implement power control
2024-03-28 fix logic level definition of charge available
2024-03-29 add temperature sensors
2024-03-29 add battery monitor
2024-03-29 check cell voltages
2024-03-29 implement shell command for battery state
2024-03-29 measure cell temperatures in main loop
2024-03-29 implement PWM for cell balancer
2024-03-29 fix PWM channel for cell balancer
2024-03-30 update balancing calculation
    [battery_system.ods]
2024-03-31 enable cell temperature measurements
2024-04-01 enable power control during startup
2024-04-05 relax temperature limits for testing
2024-04-05 start simplifying BMS for R02
    [battery-management-system.kicad_sch, battery_pack.kicad_sch, mcu.kicad_sch, power_supply.kicad_sch]
2024-04-05 update PCB from schematic
    [battery-management-system.kicad_pcb, mcu.kicad_sch]
2024-04-05 fix design errors
    [battery-management-system.kicad_pcb, battery_pack.kicad_sch, cell_measurement.kicad_sch, mcu.kicad_sch, power_supply.kicad_sch, temperature_sensors.kicad_sch, usb.kicad_sch]
2024-04-06 add heatsink and fix ERC errors
    [battery-management-system.kicad_pcb, battery-management-system.kicad_sch, cell_measurement.kicad_sch, mcu.kicad_sch, usb.kicad_sch]
2024-04-06 layout BMS R02
    [battery-management-system.kicad_pcb, cell_measurement.kicad_sch]
2024-04-06 route BMS R02
    [battery-management-system.kicad_pcb]
2024-04-06 update footprints
    [battery-management-system.kicad_pcb]
2024-04-06 update design errors list
    [battery-management-system.csv]
2024-04-06 fix schematic error in DC-DC converter, add heatsink and mounting holes
    [boost_converter.kicad_sch]
2024-04-06 create layout for DC-DC converter
    [boost_converter.kicad_sch, dc-dc-converter-24v.kicad_pcb, dc-dc-converter-24v.kicad_sch, output_filter.kicad_sch]
2024-04-06 add version on silkscreen
    [dc-dc-converter-24v.kicad_pcb]
2024-04-07 update footprint of TMG1-01
    [battery-management-system.kicad_pcb]
2024-04-07 fix RS order number
    [boost_converter.kicad_sch, dc-dc-converter-24v.kicad_pcb, output_filter.kicad_sch]
2024-04-13 add first steps for casing
    [casing.FCStd]
2024-04-13 create side wall with extrusion
    [casing.FCStd]
2024-04-13 improve wall
    [casing.FCStd]
2024-04-13 improve casing walls
    [casing.FCStd]
2024-04-14 finish sides of casing
    [casing.FCStd]
2024-04-14 add PCBs to casing
    [casing.FCStd]
2024-04-16 add PCB mounts
    [casing.FCStd]
2024-04-16 add PCB mounts and lid
    [casing.FCStd]
2024-04-16 start with lid mount
2024-04-16 create lid to base mounts
2024-04-18 add some margin to cells and PCBs
2024-04-21 improve lid mounts
2024-04-21 add exported meshes for casing
    [casing-cells.stl, casing-complete_base.stl, casing-complete_lid.stl]
2024-05-19 change default board revision for BMS to R01
    [battery-management-system.kicad_pcb]
2024-05-19 add BMS R02 device tree
2024-05-20 activate cell temperature measurements
2024-05-20 add list of design errors for BMS R02
2024-05-20 add workaround for incorrect cell voltages
    [main.c]
2024-05-20 set a reasonable maximum temperature for the cells and the PCB
2024-05-30 fix design errors in DC DC converter
    [boost_converter.kicad_sch, dc-dc-converter-24v.kicad_sch, output_filter.kicad_sch]
2024-05-30 start with redesign of DC DC converter
    [dc-dc-converter-24v.kicad_pcb, dc-dc-converter-24v.kicad_sch]
2024-05-31 layout DC DC converter
    [dc-dc-converter-24v.kicad_pcb, dc-dc-converter-24v.kicad_sch]
2024-05-31 add 3D models
    [dc-dc-converter-24v.kicad_pcb]
2024-06-01 replace tracks in power path with zones
    [dc-dc-converter-24v.kicad_pcb]
2024-06-01 improve layout of DC DC converter
    [dc-dc-converter-24v.kicad_pcb]
2024-06-01 fix cell voltage measurements
    [battery-management-system.kicad_sch, battery_pack.kicad_sch, cell_measurement.kicad_sch, mcu.kicad_sch, power_supply.kicad_sch, temperature_sensors.kicad_sch, usb.kicad_sch]
2024-06-02 add fuel gauge to BMS
    [battery-management-system.kicad_sch, battery_pack.kicad_sch, cell_balancing.kicad_sch]
2024-06-02 start with cell balancing in BMS
    [cell_balancing.kicad_sch]
2025-01-01 start with redesign of DC-DC converter
    [dc-dc-converter-24v.kicad_sch]
2025-01-06 finish redesign of schematic of DC-DC converter
    [dc-dc-converter-24v.kicad_sch]
2025-01-06 improve cooling for DC-DC converter
    [dc-dc-converter-24v.kicad_pcb, dc-dc-converter-24v.kicad_sch]
2025-01-06 used improved footprints
    [dc-dc-converter-24v.kicad_pcb]
2025-01-06 flip connectors to bottom
    [dc-dc-converter-24v.kicad_pcb]
2025-01-08 change type of heatsinks
    [dc-dc-converter-24v.kicad_pcb, dc-dc-converter-24v.kicad_sch]
2025-01-19 finish layout for dc-dc converter
    [dc-dc-converter-24v.kicad_pcb]
2025-01-19 fix design errors of battery management system R02
    [battery-management-system.kicad_pcb, battery-management-system.kicad_sch, battery_pack.kicad_sch]
2025-01-19 add heatsink to sense resistor
    [battery_pack.kicad_sch]
2025-01-25 finish cell balancing schematic
    [battery-management-system.kicad_sch, battery_pack.kicad_sch, cell_balancing.kicad_sch, cell_measurement.kicad_sch, mcu.kicad_sch, power_supply.kicad_sch, temperature_sensors.kicad_sch, usb.kicad_sch]
2025-01-25 add snubber circuit
    [battery-management-system.kicad_sch, battery_pack.kicad_sch, cell_balancing.kicad_sch, cell_measurement.kicad_sch, mcu.kicad_sch, power_supply.kicad_sch, temperature_sensors.kicad_sch, usb.kicad_sch]
2025-01-26 finish placement of BMS R03
    [battery-management-system.kicad_pcb, cell_balancing.kicad_sch]
2025-01-26 improve layout of BMS
    [battery-management-system.kicad_pcb]
2025-02-06 continue work on layout of BMS
    [battery-management-system.kicad_pcb]
2025-03-04 finish layout of BMS
    [battery-management-system.kicad_pcb, battery-management-system.kicad_sch, battery_pack.kicad_sch, cell_balancing.kicad_sch, cell_measurement.kicad_sch, mcu.kicad_sch, power_supply.kicad_sch, temperature_sensors.kicad_sch]
2025-03-04 fix silkscreen in BMS layout
    [battery-management-system.kicad_pcb]
2025-03-04 improve silkscreen of BMS
    [battery-management-system.kicad_pcb]
2025-03-04 define BOM attributes
2025-03-04 update symbols from library
    [battery_pack.kicad_sch, cell_balancing.kicad_sch]
2025-03-10 replace reset button, update symbols
    [battery-management-system.kicad_pcb, cell_measurement.kicad_sch, mcu.kicad_sch, power_supply.kicad_sch]
2025-03-10 update symbols
    [dc-dc-converter-24v.kicad_sch]
2025-03-10 add BOM
    [BOM_mouser.csv]
2025-03-11 replace inductance of power supplies
    [battery-management-system.kicad_pcb, power_supply.kicad_sch]
2025-03-11 generate BOMs
    [BOM_mouser.csv, dc-dc-converter-24v.kicad_sch]
2025-03-11 update symbols and BOM
    [BOM_mouser.csv, cell_balancing.kicad_sch, mcu.kicad_sch, usb.kicad_sch]
2025-03-11 add fabrication outputs for battery management system
    [BOM_mouser_r03.csv, battery-management-system.kicad_pcb]
2025-03-11 add fabrication outputs for DC-DC converter
    [BOM_mouser_r03.csv, dc-dc-converter-24v.kicad_pcb]
2025-03-11 add BOM for cell temperature sensor
    [BOM_mouser_r01.csv, cell-temperature-sensor.kicad_pcb, cell-temperature-sensor.kicad_sch]
2025-03-11 improve thermal connection of current sense resistor in BMS
    [battery-management-system.kicad_pcb]
2025-03-11 generate fabrication outputs for BMS
2025-03-17 update BOM export settings
2025-06-04 note wrong footprint for EEPROM in design error list
2025-06-05 define BMS R03 board for software
2025-06-05 remove software workaround for faulty cell voltages
    [main.c]
2025-06-05 document bug with sleep during cell measurements
    [cells_measurement.c]
